BjornB2/retromodem/docs/RetroModem-Quick-Reference.pdf

RetroModem quick reference | github.com/BjornB2/retromodem

# RetroModem

ONE-PAGE QUICK REFERENCE - ACCESS, URLS, DIALLING AND CONTROLS

## Access and default credentials

Administration | http://retromodem.local/
Web login | retromodem / retromodem
Fallback access point retromodem
Access-point
password
| 12345678

Administration via AP http://10.42.0.1/

SSH | Imager account @ retromodem.local

## First use

### 1. Power on and wait about 20 seconds. 2. If normal Wi-Fi

is unavailable, join retromodem using 12345678; choose stay connected if warned that it has no internet. 3. Open retromodem.local or 10.42.0.1, sign in and select Wi-Fi.
4. Rejoin normal Wi-Fi and reopen retromodem.local. 5. Select the adapter and either Direct PPP or Hayes dial-up/BBS.

## Pages for the retro device

Start | http://start.retromodem/
Client settings | http://setup.retromodem/
Wi-Fi setup | http://wifi.retromodem/

Proxy routing/images http://proxy.retromodem/

Search | http://search.retromodem/
ChatGPT | http://chatgpt.retromodem/

## Network and proxy

The retro device must use RetroModem DNS 192.168.77.1. Direct PPP and dial-up PPP assign addresses automatically. Palm fallback: device IP 192.168.77.2, primary and secondary DNS 192.168.77.1. Fresh installations automatically send HTTP traffic through RetroWEB; change this at proxy.retromodem. Manual proxy: 192.168.77.1:8080.

## Virtual modem and dialling

Internet PPP | ATDT5559000 | user / blank
Bundled BBS entries | ATDT5551000 ... 5551009
ChatGPT BBS | ATDT5559999
Virtual Hayes speed | 115200 bit/s
Test command | AT -> OK

Phone-book numbers map modern Telnet BBS hostnames and ports to virtual telephone numbers; no physical telephone call is made.

## Button and LEDs

Short button press: switch Direct PPP / Hayes dial-up-BBS.
Hold 3 seconds: safe shutdown. Release when both LEDs flash; disconnect power only after the LEDs turn off. Status LEDs: show the active modem mode plus startup/network state.

## Connection hardware

MY018 GPIO/UART: preferred infrared build, tested up to 57.6 kbit/s. Prolific USB-RS-232: main wired route; use the correct device/null-modem cable. MA-620 USB IR: fallback infrared adapter at 9600 bit/s.

## SSH

ssh YOUR_USERNAME@retromodem.local
Use the account/password or key created in Raspberry Pi Imager. Through the fallback access point, replace the hostname with 10.42.0.1.

## Safety and help

Do not use the rewriting proxy for passwords, payments or sensitive accounts. Use http:// addresses in old browsers. Complete installation, wiring and device guides: github.com/BjornB2/retromodem.
