BjornB2/retromodem/docs/my018-aansluitschema.png

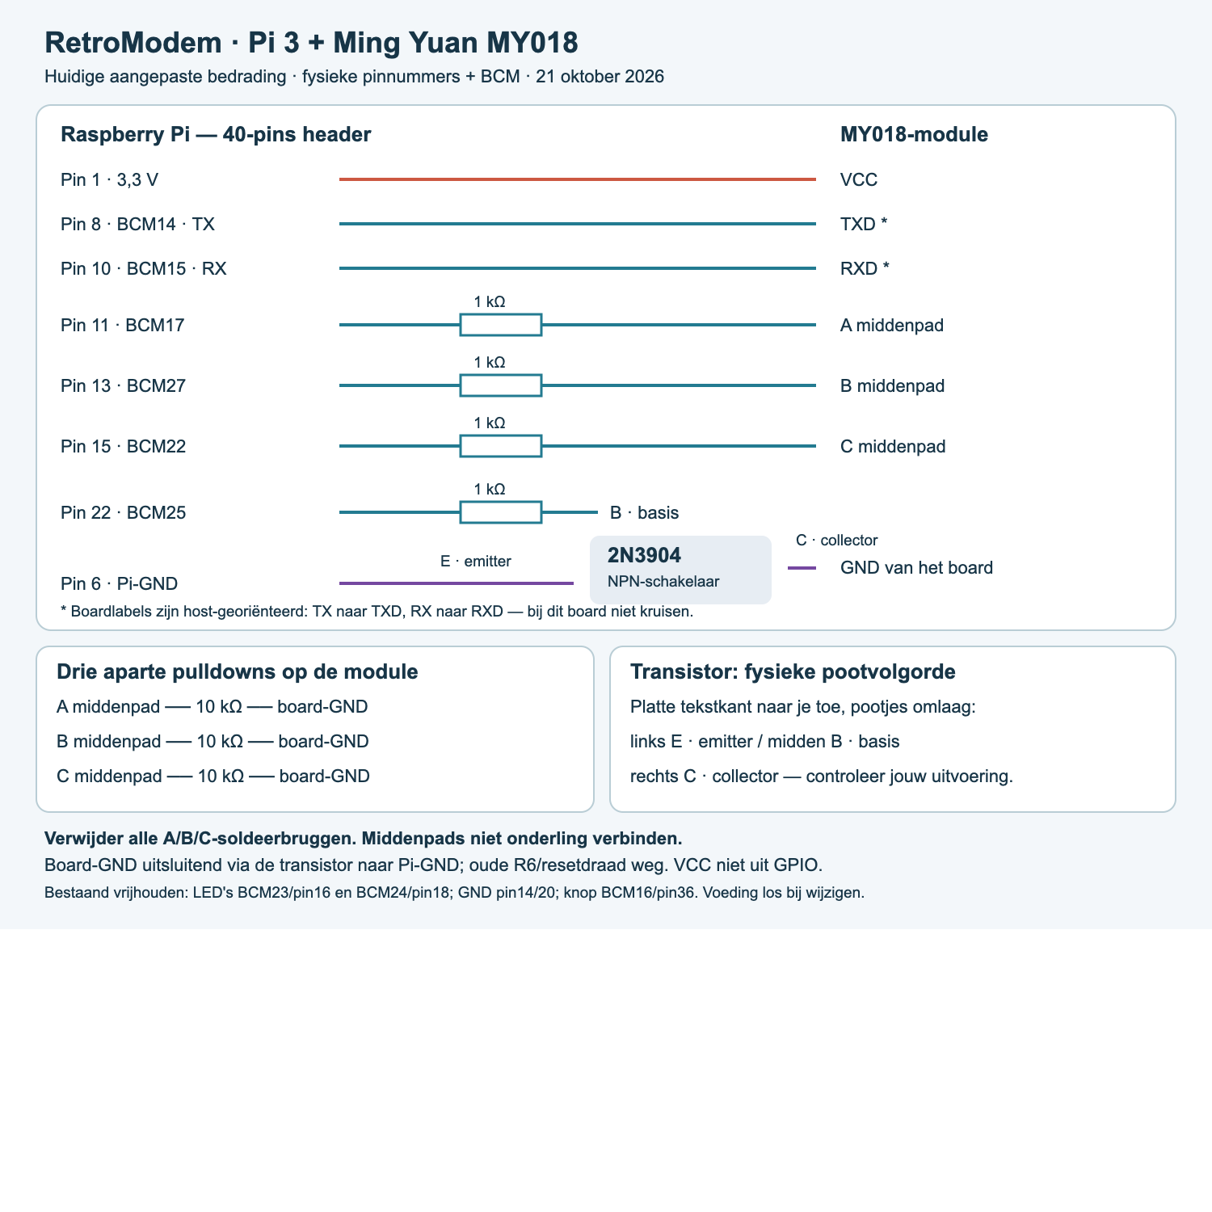
docs/my018-aansluitschema.png
