BjornB2/retromodem/docs/retromodem-hero.jpg

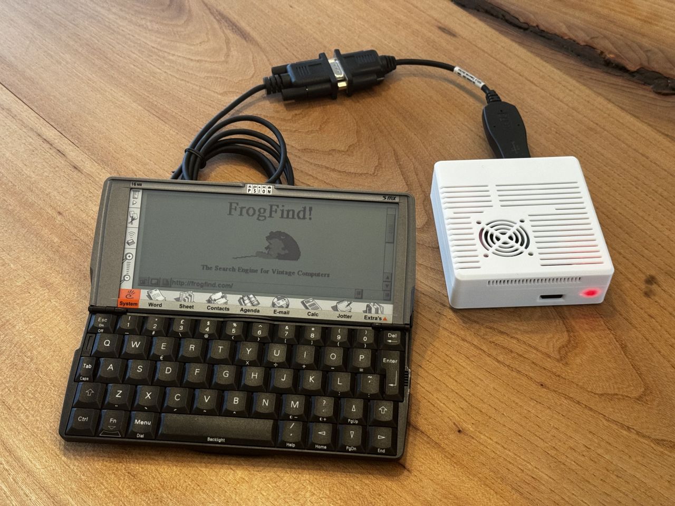
docs/retromodem-hero.jpg
