BjornB2/retromodem/docs/retroweb-interface.webp

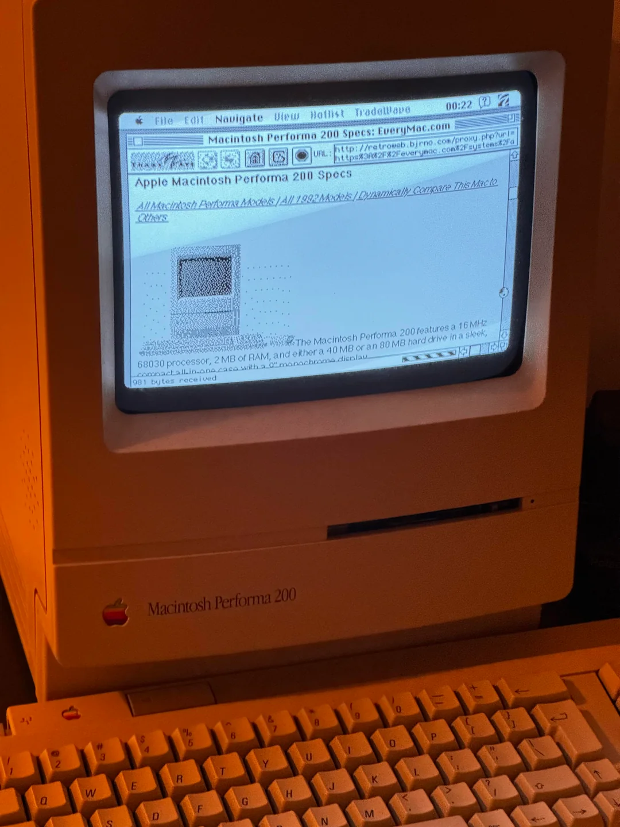
docs/retroweb-interface.webp
