BjornB2/retromodem/hardware/enclosure/RetroModem.step

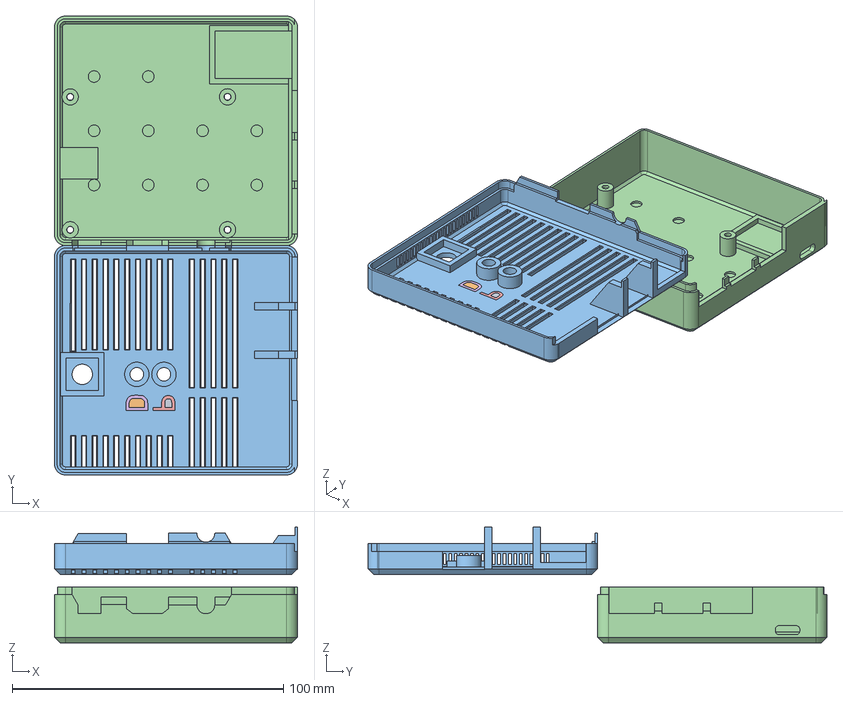
[picture p12: CAD file, 2026-10-28]
hardware/enclosure/RetroModem.step
89.6 x 169.2 x 42.6 mm
Case_Lid
Case_Main
