BjornB2/retromodem/hardware/enclosure/Retromodem_Bottom.stl

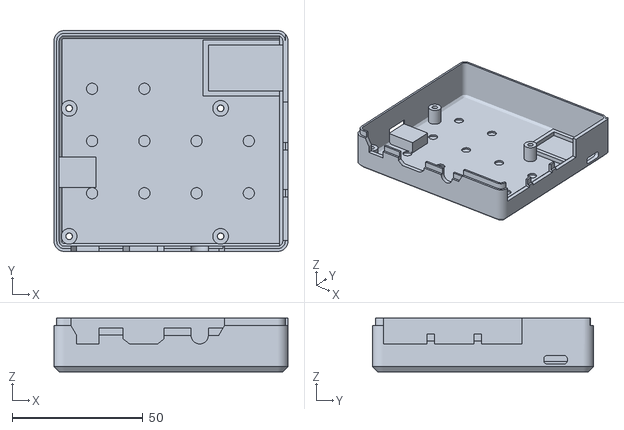
[picture p13: CAD file, 2026-10-28]
hardware/enclosure/Retromodem_Bottom.stl
89.6 x 84.6 x 20.6
