BjornB2/retromodem/hardware/enclosure/RetroModem_Lid.stl

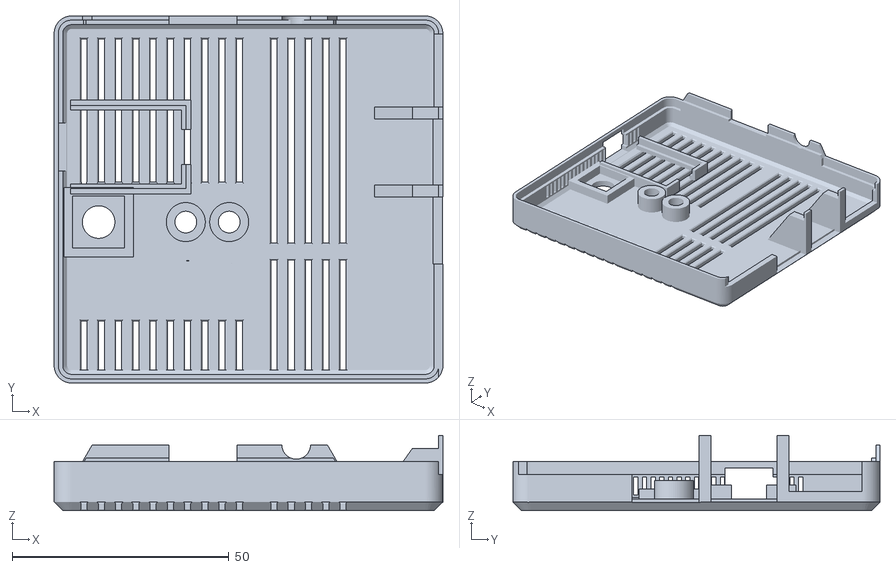
[picture p14: CAD file, 2026-10-28]
hardware/enclosure/RetroModem_Lid.stl
89.6 x 84.6 x 17.4
