BjornB2/retromodem/web/web.py

#!/usr/bin/python3
"""Small dependency-free configuration UI for the RetroModem appliance."""

from __future__ import annotations

import base64
import fcntl
import hashlib
import hmac
import html
import json
from email import policy
from email.parser import BytesParser
import os
import re
import secrets
import shlex
import signal
import subprocess
import tempfile
import threading
import time
import urllib.parse
from http import HTTPStatus
from http.cookies import SimpleCookie
from http.server import BaseHTTPRequestHandler, ThreadingHTTPServer
from pathlib import Path

try:
    import openai_auth
except ModuleNotFoundError:
    from web import openai_auth

CONFIG = Path("/etc/retromodem/retromodem.env")
PHONEBOOK = Path("/etc/retromodem/phonebook.json")
TRANSFERS = Path("/var/lib/retromodem/transfers")
RECEIVED = TRANSFERS / "received"
STATIC_ROOT = Path("/usr/local/share/retromodem/static")
LIBRARY_ROOT = Path("/var/lib/retromodem/software-library")
LIBRARY_META = LIBRARY_ROOT / "library.json"
SOFTWARE = {
    "psion-connectivity-3.10": {
        "name": "Mobile Connectivity Update 3.10",
        "file": "software/MobileConnectivityUpdate3.10.sis",
        "target": "psion", "protocol": "ymodem",
        "description_nl": "Update voor de mobiele verbindingssoftware van de Psion. Optioneel: installeer deze wanneer je EPOC-installatie de benodigde modem- of verbindingsopties mist.",
        "description_en": "Update for Psion mobile connectivity software. Optional: install when your EPOC installation lacks the required modem or connection options.",
        "compatibility": "Psion / EPOC · 3.10 · SIS",
    },
    "psion-web": {
        "name": "Web voor Psion",
        "file": "software/web.sis", "target": "psion", "protocol": "ymodem",
        "description_nl": "Webbrowser voor Psion/EPOC, geleverd als SIS-installatiepakket. Gebruik RetroWEB voor het bezoeken van moderne websites.",
        "description_en": "Web browser for Psion/EPOC, supplied as a SIS installation package. Use RetroWEB to browse modern websites.",
        "compatibility": "Psion / EPOC · SIS",
    },
    "psion-nirc": {
        "name": "nIRC",
        "file": "software/nirc.sis", "target": "psion", "protocol": "ymodem",
        "description_nl": "IRC-chatclient voor Psion/EPOC. Maak een internetverbinding en configureer in de app een IRC-server om aan kanalen en gesprekken deel te nemen.",
        "description_en": "IRC chat client for Psion/EPOC. Connect to the internet and configure an IRC server in the app to join channels and conversations.",
        "compatibility": "Psion / EPOC · SIS",
    },
    "palmterm-retromodem-0.1.34": {
        "name": "PalmTerm for RetroModem 0.1.34",
        "file": "software/PalmTerm-RetroIRModem-0.1.34.prc",
        "description_nl": "ANSI/VT100-terminal met kleur, CP437, scrollback en 80×25-overzicht. Inclusief RetroModem BBS- en ChatGPT-telefoonboek.",
        "description_en": "ANSI/VT100 terminal with colour, CP437, scrollback and an 80×25 overview. Includes the RetroModem BBS and ChatGPT phone book.",
        "compatibility": "Palm OS 4.0/4.1 · Palm IIIc · MIT",
        "source": "https://github.com/BjornB2/PalmTerm",
        "protocol": "palm",
    },
    "rbrowser-0.1.35": {
        "name": "RetroModem Browser 0.1.35",
        "file": "software/RBrowser-0.1.35.prc",
        "description_nl": "Browser voor RetroWEB met eenvoudige HTML-weergave en inline GIF-afbeeldingen. Startpagina: retroweb.bjrno.com.",
        "description_en": "Browser for RetroWEB with basic HTML rendering and inline GIF images. Home page: retroweb.bjrno.com.",
        "compatibility": "Palm OS 4.0/4.1 · Palm IIIc · MIT",
        "source": "https://github.com/BjornB2/palm-retroweb-browser",
        "protocol": "palm",
    },
    "eudoraweb-2.1": {
        "name": "EudoraWeb 2.1",
        "file": "software/EudoraWeb_2.1.prc",
        "description_nl": "Snelle tekstbrowser zonder afbeeldingen. Getest met installatie via Palm Beam op Palm OS 4.1.",
        "description_en": "Fast text browser without images. Installation over Palm Beam tested on Palm OS 4.1.",
        "compatibility": "Palm OS 3.0–5.4 · freeware",
        "source": "https://palmdb.net/app/eudora-eis",
        "protocol": "palm",
    },
    "mocha-telnet-3.0": {
        "name": "Mocha Telnet 3.0",
        "file": "software/MochaTelnet_3.0.prc",
        "description_nl": "Telnet/VT100/VT220- en SSH2-client voor klassieke Palms. Freewaresleutel: 119377.",
        "description_en": "Telnet/VT100/VT220 and SSH2 client for classic Palms. Freeware key: 119377.",
        "compatibility": "Palm OS 3.0+ · freeware",
        "source": "https://www.mochasoft.dk/palm2.htm",
        "protocol": "palm",
    },
}
ALLOWED_BITRATES = {"9600", "19200", "38400", "57600", "115200"}
CSRF_TOKENS: set[str] = set()
GUIDE_TARGETS = {"generic", "psion", "palm-old", "palm-new", "hp200lx", "win95", "win98", "winxp"}
LIBRARY_PROTOCOLS = {"download", "palm", "epoc", "xmodem", "ymodem", "zmodem"}
IR_ADAPTERS = {
    "ming-yuan-my018": {"name": "Ming Yuan MY018 · GPIO", "prefix": "MY018", "tty": "/dev/serial0", "dongle": ""},
    "mobile-action-ma620": {"name": "Mobile Action MA-620 · USB fallback", "prefix": "MA620", "tty": "auto", "dongle": "ma600"},
}


def pending_send() -> dict[str, str] | None:
    """Resolve only a web-created work copy, never an arbitrary posted path."""
    try:
        item = json.loads((TRANSFERS / "pending-send.json").read_text())
        token, name = item["token"], item["filename"]
        if not re.fullmatch(r"work-[a-f0-9]{12}", token) or Path(name).name != name:
            return None
        candidate = TRANSFERS / token / name
        if candidate.parent.resolve().parent != TRANSFERS.resolve() or candidate.is_symlink() or not candidate.is_file():
            return None
        return {"token": token, "filename": name, "protocol": item["protocol"]}
    except (OSError, ValueError, KeyError, TypeError):
        return None


def remember_send(path: Path, protocol: str) -> None:
    save = {"token": path.parent.name, "filename": path.name, "protocol": protocol}
    target = TRANSFERS / "pending-send.json"
    temporary = target.with_suffix(".tmp")
    temporary.write_text(json.dumps(save), encoding="utf-8")
    os.replace(temporary, target)


def ir_adapter_id(config: dict[str, str]) -> str:
    value = config.get("RETROMODEM_ADAPTER", "ming-yuan-my018")
    return value if value in IR_ADAPTERS else "ming-yuan-my018"


def my018_power_enabled(config: dict[str, str]) -> bool:
    return config.get("RETROMODEM_MY018_POWER_CYCLE", "0") == "1"


def ir_adapter_settings(config: dict[str, str], language: str) -> str:
    active = ir_adapter_id(config)
    options = ''.join(f'<option value="{key}" {"selected" if key == active else ""}>{item["name"]}</option>' for key, item in IR_ADAPTERS.items())
    result = f'<label>{tr(language,"Infraroodadapter","Infrared adapter")}</label><select name="irda_adapter" id="irda-adapter">{options}</select>'
    for key, item in IR_ADAPTERS.items():
        prefix = item["prefix"]
        current = key == active
        physical = config.get(f"RETROMODEM_{prefix}_BITRATE", config.get("RETROMODEM_IRDA_BITRATE", "9600") if current else "9600")
        virtual = config.get(f"RETROMODEM_{prefix}_DIALUP_BITRATE", config.get("RETROMODEM_IRDA_DIALUP_BITRATE", "115200") if current else "115200")
        my018 = key == "ming-yuan-my018"
        controlled = my018_power_enabled(config)
        if my018:
            message = (tr(language, "Automatische snelheidskeuze via A/B/C en de transistorschakeling. Getest op 57k6: PPP met Palm IIIc en Psion 5mx, en Palm Beam naar de Palm. 38k4 is nog niet getest; 19k2 is alleen gedeeltelijk getest.", "Automatic speed selection through A/B/C and the transistor power switch. Tested at 57.6k: PPP with Palm IIIc and Psion 5mx, and Beam to Palm. 38.4k is untested; 19.2k was only partially tested.") if controlled else tr(language, "Vaste 9600-configuratie: bruggen A0/B0/C0. Hogere snelheden vereisen aangepaste bedrading, een voedingsschakelaar en de bijbehorende driver; sluit GPIO-draden niet aan op gesloten bruggen.", "Fixed 9600 configuration: A0/B0/C0 bridges. Higher rates require modified wiring, a power switch and the matching driver; never connect GPIO outputs to closed bridges."))
        else:
            message = tr(language,"Met deze MA-620 is alleen 9600 bit/s betrouwbaar gebleken. Hogere waarden zijn experimenteel.","Only 9600 bps has proven reliable with this MA-620. Higher settings are experimental.")
        rates = ("9600",) if my018 and not controlled else ("9600", "19200", "38400", "57600", "115200")
        labels = {"9600": "9600", "19200": tr(language, "19200 — gedeeltelijk getest", "19200 — partially tested"), "38400": tr(language, "38400 — nog niet getest", "38400 — untested"), "57600": tr(language, "57600 — getest, aanbevolen", "57600 — tested, recommended"), "115200": tr(language, "115200 — experimenteel, waarschuwing", "115200 — experimental, warning")}
        choices = ''.join(f'<option value="{rate}" {"selected" if rate == physical else ""}>{labels[rate] if my018 else rate}</option>' for rate in rates)
        virtual_choices = ''.join(f'<option value="{rate}" {"selected" if rate == virtual else ""}>{rate}</option>' for rate in ("9600", "19200", "38400", "57600", "115200"))
        warning = (f'<p class="notice warning" data-speed-warning="115200" role="status" {"" if physical == "115200" else "hidden"}>{tr(language,"115k2 is niet stabiel aangetoond: onze Palm Beam-tests leverden geen werkende verbinding op. Ook Psion PPP op 115k2 is niet bevestigd. Dit is geen algemene IrDA-limiet. Kies bij problemen 57k6 of 9600 en verbind opnieuw.","115.2k is not proven stable: our Palm Beam tests failed to connect. Psion PPP at 115.2k is also unconfirmed. This is not a general IrDA limit. If it fails, select 57.6k or 9600 and reconnect.")}</p>' if my018 else '')
        result += f'<div data-ir-profile="{key}"><h3>{item["name"]}</h3><p class="notice {"" if my018 else "warning"}">{message}</p><label>{tr(language,"Maximale fysieke IrDA-linksnelheid","Maximum physical IrDA link speed")}</label><select name="{prefix.lower()}_bitrate">{choices}</select>{warning}<p class="helper">{tr(language,"Ontdekking begint op 9600 bit/s. Daarna onderhandelen de apparaten een snelheid tot dit maximum. Een gewijzigde limiet geldt voor een nieuwe verbinding; toepassen verbreekt de huidige sessie.","Discovery starts at 9600 bps, then devices negotiate up to this maximum. A changed limit applies to a new connection; applying disconnects the current session.")}</p><label>{tr(language,"Virtuele poortsnelheid voor inbelmodem/Comms","Virtual port speed for dial-up modem/Comms")}</label><select name="{prefix.lower()}_dialup_bitrate">{virtual_choices}</select><p class="helper">{tr(language,"De virtuele poortsnelheid verandert de fysieke infraroodsnelheid niet. Instellingen worden per adapter bewaard.","The virtual port speed does not change the physical infrared speed. Settings are saved separately for each adapter.")}</p></div>'
    return result


def load_config() -> dict[str, str]:
    values = {k: v for k, v in os.environ.items() if k.startswith("RETROMODEM_")}
    try:
        lines = CONFIG.read_text(encoding="utf-8").splitlines()
    except FileNotFoundError:
        lines = []
    for line in lines:
        if not line or line.lstrip().startswith("#") or "=" not in line:
            continue
        key, value = line.split("=", 1)
        if re.fullmatch(r"RETROMODEM_[A-Z0-9_]+", key):
            try:
                parsed = shlex.split(value, posix=True)
                values[key] = parsed[0] if parsed else ""
            except ValueError:
                continue
    return values


CONFIG_WRITE_LOCK = threading.RLock()


def save_config(changes: dict[str, str]) -> None:
    CONFIG.parent.mkdir(parents=True, exist_ok=True)
    with CONFIG_WRITE_LOCK:
        fd = os.open(str(CONFIG) + '.lock', os.O_CREAT | os.O_RDWR | os.O_NOFOLLOW, 0o600)
        with os.fdopen(fd, 'a') as lock:
            fcntl.flock(lock, fcntl.LOCK_EX)
            _save_config_unlocked(changes)


def _save_config_unlocked(changes: dict[str, str]) -> None:
    current = load_config()
    current.update(changes)
    lines = [f"{key}={shlex.quote(current[key])}" for key in sorted(current)]
    CONFIG.parent.mkdir(parents=True, exist_ok=True)
    fd, name = tempfile.mkstemp(prefix="retromodem.env.", dir=CONFIG.parent, text=True)
    try:
        with os.fdopen(fd, "w", encoding="utf-8") as stream:
            stream.write("\n".join(lines) + "\n")
        os.chmod(name, 0o600)
        os.replace(name, CONFIG)
    finally:
        try:
            os.unlink(name)
        except FileNotFoundError:
            pass


def load_phonebook() -> list[dict[str, object]]:
    try:
        document = json.loads(PHONEBOOK.read_text(encoding="utf-8"))
        entries = document.get("entries", [])
    except (FileNotFoundError, json.JSONDecodeError, AttributeError):
        return []
    return entries if isinstance(entries, list) else []


def save_phonebook(entries: list[dict[str, object]]) -> None:
    PHONEBOOK.parent.mkdir(parents=True, exist_ok=True)
    fd, name = tempfile.mkstemp(prefix="phonebook.json.", dir=PHONEBOOK.parent, text=True)
    try:
        with os.fdopen(fd, "w", encoding="utf-8") as stream:
            json.dump({"schema_version": 1, "entries": entries}, stream, indent=2, ensure_ascii=False)
            stream.write("\n")
        os.chmod(name, 0o600)
        os.replace(name, PHONEBOOK)
    finally:
        try:
            os.unlink(name)
        except FileNotFoundError:
            pass


def load_library() -> dict[str, dict[str, str]]:
    try:
        document = json.loads(LIBRARY_META.read_text(encoding="utf-8"))
        items = document.get("items", {})
    except (FileNotFoundError, json.JSONDecodeError, AttributeError):
        return {}
    if not isinstance(items, dict):
        return {}
    return {str(key): value for key, value in items.items() if isinstance(value, dict)}


def save_library(items: dict[str, dict[str, str]]) -> None:
    LIBRARY_ROOT.mkdir(parents=True, exist_ok=True)
    fd, name = tempfile.mkstemp(prefix="library.", suffix=".json", dir=LIBRARY_ROOT, text=True)
    try:
        with os.fdopen(fd, "w", encoding="utf-8") as stream:
            json.dump({"schema_version": 1, "items": items}, stream, indent=2, ensure_ascii=False)
            stream.write("\n")
        os.chmod(name, 0o600)
        os.replace(name, LIBRARY_META)
    finally:
        try:
            os.unlink(name)
        except FileNotFoundError:
            pass


def software_catalog() -> dict[str, dict[str, object]]:
    catalog = {key: dict(value, uploaded=False) for key, value in SOFTWARE.items()}
    catalog.update({key: dict(value, uploaded=True) for key, value in load_library().items()})
    for item in catalog.values():
        if item.get('protocol') == 'download':
            item['protocol'] = 'ymodem'
    return catalog


def library_filename(item: dict[str, object], source: Path) -> str:
    """Keep storage IDs private; retain the original name on the wire."""
    name = Path(str(item.get('original_name') or source.name)).name
    name = re.sub(r'[^A-Za-z0-9._ -]', '_', name)[:120]
    return name if name not in {'', '.', '..'} else 'bestand.bin'


def save_transfer_status(document: dict[str, object]) -> None:
    TRANSFERS.mkdir(parents=True, exist_ok=True)
    fd, name = tempfile.mkstemp(prefix="status.", suffix=".json", dir=TRANSFERS, text=True)
    try:
        with os.fdopen(fd, "w", encoding="utf-8") as stream:
            json.dump(document, stream, ensure_ascii=False)
        os.chmod(name, 0o644)
        os.replace(name, TRANSFERS / "status.json")
    finally:
        try:
            os.unlink(name)
        except FileNotFoundError:
            pass


def transfer_process_alive(status: dict[str, object]) -> bool:
    try:
        pid = int(status.get("pid", 0))
        command = Path(f"/proc/{pid}/cmdline").read_bytes().replace(b"\0", b" ")
    except (FileNotFoundError, ValueError, PermissionError):
        return False
    return b"retromodem/transfer.py" in command


def phonebook_entry(form: dict[str, str]) -> dict[str, object]:
    number = form.get("number", "").strip()
    label = form.get("label", "").strip()
    kind = form.get("kind", "bbs")
    host = form.get("host", "").strip()
    try:
        port = int(form.get("port", "0"))
    except ValueError as error:
        raise ValueError("Ongeldige poort") from error
    if not re.fullmatch(r"[0-9*#]{1,32}", number):
        raise ValueError("Een telefoonnummer mag alleen cijfers, * en # bevatten")
    if not label or len(label) > 80:
        raise ValueError("Ongeldige naam")
    if kind not in {"ppp", "bbs"}:
        raise ValueError("Ongeldig type")
    if not re.fullmatch(r"[A-Za-z0-9.-]{1,253}", host) or ".." in host:
        raise ValueError("Ongeldige hostnaam")
    if not 1 <= port <= 65535:
        raise ValueError("Ongeldige poort")
    return {"number": number, "label": label, "kind": kind, "host": host, "port": port}


def run(*args: str, timeout: int = 8, env: dict[str, str] | None = None) -> subprocess.CompletedProcess[str]:
    try:
        return subprocess.run(args, text=True, capture_output=True, timeout=timeout, check=False, env=env)
    except (FileNotFoundError, subprocess.TimeoutExpired) as error:
        return subprocess.CompletedProcess(args, 127, "", str(error))


def service_active(name: str) -> bool:
    return run("/usr/bin/systemctl", "is-active", "--quiet", name).returncode == 0


def process_running(name: str) -> bool:
    return run("/usr/bin/pgrep", "-x", name).returncode == 0


def wifi_state(config: dict[str, str]) -> tuple[str, str]:
    interface = config.get("RETROMODEM_WIFI_INTERFACE", "wlan0")
    result = run("/usr/bin/nmcli", "-g", "GENERAL.STATE,GENERAL.CONNECTION", "device", "show", interface)
    fields = result.stdout.strip().splitlines()
    state = fields[0] if fields else "onbekend"
    profile = fields[1] if len(fields) > 1 else ""
    ssid = ""
    if profile and profile not in {"--", "—"}:
        ssid_result = run("/usr/bin/nmcli", "-g", "802-11-wireless.ssid", "connection", "show", profile)
        if ssid_result.returncode == 0:
            ssid = ssid_result.stdout.strip().splitlines()[0] if ssid_result.stdout.strip() else ""
    return state, ssid


def scan_wifi(config: dict[str, str]) -> list[tuple[str, int, str]]:
    interface = config.get("RETROMODEM_WIFI_INTERFACE", "wlan0")
    result = run(
        "/usr/bin/nmcli", "-t", "--escape", "yes",
        "-f", "SSID,SIGNAL,SECURITY", "device", "wifi", "list",
        "ifname", interface, "--rescan", "yes", timeout=20,
    )
    networks: dict[str, tuple[int, str]] = {}
    for line in result.stdout.splitlines():
        # nmcli escapes literal colons as \:; split only unescaped separators.
        parts = re.split(r"(?<!\\):", line, maxsplit=2)
        if len(parts) != 3:
            continue
        ssid = parts[0].replace(r"\:", ":").replace(r"\\", "\\")
        if not ssid or ssid == config.get("RETROMODEM_AP_SSID", "retromodem"):
            continue
        try:
            signal = int(parts[1])
        except ValueError:
            signal = 0
        if ssid not in networks or signal > networks[ssid][0]:
            networks[ssid] = (signal, parts[2] or "open")
    return sorted(((ssid, *data) for ssid, data in networks.items()), key=lambda item: -item[1])


def usb_inventory() -> list[dict[str, str]]:
    """Return known and unknown USB adapters, including their tty node."""
    known = {
        "0df7:0620": ("Mobile Action MA-620", "irda"),
        "067b:2303": ("Prolific PL2303", "serial"),
    }
    ttys: dict[str, str] = {}
    for candidate in sorted(Path("/dev").glob("ttyUSB*")):
        info = run("/usr/bin/udevadm", "info", "--query=property", f"--name={candidate}").stdout
        properties = dict(line.split("=", 1) for line in info.splitlines() if "=" in line)
        usb_id = f"{properties.get('ID_VENDOR_ID', '')}:{properties.get('ID_MODEL_ID', '')}".lower()
        if usb_id != ":":
            ttys[usb_id] = str(candidate)
    found: list[dict[str, str]] = []
    for line in run("/usr/bin/lsusb").stdout.splitlines():
        match = re.search(r"ID ([0-9a-fA-F]{4}:[0-9a-fA-F]{4}) (.+)$", line)
        if not match:
            continue
        usb_id, description = match.group(1).lower(), match.group(2).strip()
        if usb_id not in known and usb_id not in ttys:
            continue
        name, transport = known.get(usb_id, (description, "other"))
        found.append({"usb_id": usb_id, "name": name, "description": description,
                      "transport": transport, "tty": ttys.get(usb_id, "—")})
    return found


def ipv4_addresses() -> list[str]:
    result = run("/usr/bin/hostname", "-I")
    return [address for address in result.stdout.split() if ":" not in address]


def transfer_status() -> dict[str, object]:
    try:
        status = json.loads((TRANSFERS / "status.json").read_text(encoding="utf-8"))
        return status if isinstance(status, dict) else {}
    except (FileNotFoundError, json.JSONDecodeError):
        return {}


def tr(language: str, nl: str, en: str) -> str:
    return en if language == "en" else nl


def human_size(size: int) -> str:
    if size >= 1024 * 1024:
        return f"{size / (1024 * 1024):.1f} MB"
    if size >= 1024:
        return f"{size / 1024:.1f} kB"
    return f"{size} bytes"


def transfer_estimate(size: int, protocol: str, config: dict[str, str]) -> str:
    """Return a deliberately conservative estimate for the active transport."""
    ir_only = protocol in {"palm", "epoc", "windows"}
    transport = "irda" if ir_only else config.get("RETROMODEM_TRANSPORT", "irda")
    if transport == "irda":
        configured = int(config.get("RETROMODEM_IRDA_BITRATE", "9600"))
        # This MA-620 specimen is only physically verified at 9600 bit/s;
        # the virtual 115200-baud IrCOMM setting does not raise air throughput.
        bitrate = min(configured, 9600) if ir_adapter_id(config) == "mobile-action-ma620" else configured
        medium = "IR"
    else:
        bitrate = int(config.get("RETROMODEM_SERIAL_BITRATE", "115200"))
        medium = tr(config.get("RETROMODEM_LANGUAGE", "en"), "USB-serieel", "USB serial")
    efficiency = {"xmodem": 0.70, "ymodem": 0.78, "zmodem": 0.82,
                  "palm": 0.72, "epoc": 0.72, "windows": 0.72}.get(protocol, 0.75)
    seconds = max(1, int((size * 10 / max(1, bitrate) / efficiency) + (3 if transport == "irda" else 1) + 0.999))
    if seconds < 60:
        duration = f"±{seconds} sec"
    else:
        minutes, remainder = divmod(seconds, 60)
        duration = f"±{minutes}:{remainder:02d} min"
    return f"{duration} via {medium} ({bitrate} bit/s)"


def software_card(language: str, *, title: str, description: str, compatibility: str,
                  software_id: str = "", source: str = "") -> str:
    """Render one guide download with only actions the appliance can honour."""
    actions = []
    metadata = [compatibility]
    if software_id:
        item = software_catalog()[software_id]
        uploaded = bool(item.get("uploaded"))
        asset = ((LIBRARY_ROOT / Path(str(item.get("stored_name", ""))).name)
                 if uploaded else STATIC_ROOT / str(item["file"]))
        if asset.is_file():
            size = asset.stat().st_size
            metadata.append(human_size(size))
            if item.get("protocol") != "download":
                metadata.append(transfer_estimate(
                    size, str(item.get("protocol", "download")), load_config()
                ))
        href = (f'/library/download?id={urllib.parse.quote(software_id)}' if uploaded
                else f'/static/{item["file"]}')
        actions.append(
            f'<a class="button secondary" download href="{href}">'
            f'{tr(language,"Downloaden","Download")}</a>'
        )
        if item.get("protocol") != "download":
            send_label = (tr(language, "Via YMODEM versturen", "Send via YMODEM") if item.get("protocol") == "ymodem" else tr(language, "Via IR versturen", "Send over IR")
                          if item.get("protocol") in {"palm", "epoc"}
                          else tr(language, "Naar apparaat sturen", "Send to device"))
            actions.append(
                f'<form method="post" action="/transfer/library-send">'
                f'<input type="hidden" name="csrf" value="{{{{csrf}}}}">'
                f'<input type="hidden" name="software" value="{html.escape(software_id, quote=True)}">'
                f'<button class="primary" type="submit">{send_label}</button>'
                f'</form>'
            )
        if uploaded:
            actions.append(
                f'<form method="post" action="/guides/library-delete" '
                f'onsubmit="return confirm(\'{tr(language,"Dit bestand verwijderen?","Delete this file?")}\')">'
                f'<input type="hidden" name="csrf" value="{{{{csrf}}}}">'
                f'<input type="hidden" name="software" value="{html.escape(software_id, quote=True)}">'
                f'<button class="ghost" type="submit">{tr(language,"Verwijderen","Delete")}</button>'
                f'</form>'
            )
    if source:
        actions.append(
            f'<a class="button ghost" rel="noopener" href="{html.escape(source, quote=True)}">'
            f'{tr(language,"Bron / project","Source / project")}</a>'
        )
    return (
        f'<article class="software-card"><div><h3>{html.escape(title)}</h3>'
        f'<p>{description}</p><small class="helper">{" · ".join(metadata)}</small></div>'
        f'<div class="software-actions">{"".join(actions)}</div></article>'
    )


def uploaded_guide_sections(language: str) -> str:
    """Return escaped, per-guide HTML fragments for user-uploaded files."""
    grouped: dict[str, list[str]] = {target: [] for target in GUIDE_TARGETS}
    for software_id, item in load_library().items():
        target = str(item.get("target", "generic"))
        if target not in grouped:
            continue
        grouped[target].append(software_card(
            language,
            title=str(item.get("title", item.get("original_name", "Bestand"))),
            description=html.escape(str(item.get("description", ""))),
            compatibility=html.escape(str(item.get("compatibility", ""))),
            software_id=software_id,
        ))
    sections = {
        target: (f'<h3>{tr(language,"Zelf toegevoegde bestanden","Uploaded files")}</h3>'
                 f'<div class="software-list">{"".join(cards)}</div>')
        for target, cards in grouped.items() if cards
    }
    return json.dumps(sections, ensure_ascii=False).replace("<", "\\u003c")


def library_upload_form(language: str) -> str:
    return files_upload_form(language)


FILE_SYSTEMS = {'palm': 'Palm OS', 'psion': 'Psion / EPOC', 'dos': 'DOS', 'windows': 'Windows', 'generic': 'Algemeen / General'}


def file_os(target):
    return {'palm-old': 'palm', 'palm-new': 'palm', 'hp200lx': 'dos',
            'win95': 'windows', 'win98': 'windows', 'winxp': 'windows'}.get(target, target if target in FILE_SYSTEMS else 'generic')


def files_upload_form(language):
    options = ''.join(f'<option value="{key}">{label}</option>' for key, label in FILE_SYSTEMS.items())
    return f'''<details class="card"><summary>{tr(language,'Bestand toevoegen','Add file')}</summary><form method="post" action="/guides/upload" enctype="multipart/form-data"><input type="hidden" name="csrf" value="{{{{csrf}}}}"><label>{tr(language,'Bestand','File')}</label><input type="file" name="file" required><label>OS</label><select name="target">{options}</select><label>{tr(language,'Bron-URL (optioneel)','Source URL (optional)')}</label><input type="url" name="source" maxlength="2048" placeholder="https://github.com/…"><label>{tr(language,'Titel','Title')}</label><input name="title" maxlength="80" required><label>{tr(language,'Beschrijving','Description')}</label><input name="description" maxlength="240" required><label>{tr(language,'Versie / compatibiliteit','Version / compatibility')}</label><input name="compatibility" maxlength="120"><label>{tr(language,'Overdrachtsmethode','Transfer method')}</label><select name="protocol"><option value="palm">Palm Beam (PRC/PDB)</option><option value="ymodem">YMODEM</option><option value="xmodem">XMODEM</option><option value="zmodem">ZMODEM</option><option value="epoc">EPOC EikonIr</option></select><button type="submit">{tr(language,'Toevoegen','Add')}</button></form></details>'''


def files_library(language):
    groups = {key: [] for key in FILE_SYSTEMS}
    for software_id, original in software_catalog().items():
        item = dict(original)
        uploaded = bool(item.get('uploaded'))
        asset = LIBRARY_ROOT / Path(str(item.get('stored_name', ''))).name if uploaded else STATIC_ROOT / str(item['file'])
        if not asset.is_file():
            continue
        target = file_os(str(item.get('target', 'palm' if not uploaded else 'generic')))
        groups[target].append(software_card(language, title=str(item.get('title', item.get('name', asset.name))),
            description=html.escape(str(item.get('description_' + language, item.get('description', '')))), compatibility=html.escape(str(item.get('compatibility', ''))), software_id=software_id, source=str(item.get('source', ''))))
    labels = dict(FILE_SYSTEMS, generic=tr(language,'Algemeen','General'))
    psion_notice = '<div class="notice">' + tr(language,'<strong>Versturen via YMODEM in Comms.</strong> Directe IR-bestandsoverdracht (EikonIr) werkt minder betrouwbaar. Open op de Psion Comms, kies Ontvangen en YMODEM en start daarna hier het verzenden. Open na ontvangst het SIS-bestand op de Psion om het te installeren.','<strong>Send using YMODEM in Comms.</strong> Direct IR file transfer (EikonIr) is less reliable. On the Psion open Comms, select Receive and YMODEM, then start sending here. After receipt, open the SIS file on the Psion to install it.') + '</div>'
    tabs = ''.join(f'<button type="button" role="tab" data-file-os="{key}">{label}</button>' for key,label in labels.items())
    panels = ''.join(f'<section class="card file-os" id="files-{key}"><h2>{label}</h2><div class="software-list">' + (''.join(groups[key]) or '<p>' + tr(language,'Nog geen bestanden. Voeg hierboven een bestand toe.','No files yet. Add a file above.') + '</p>') + '</div></section>' for key,label in FILE_SYSTEMS.items())
    panels = panels.replace('class="card file-os"', 'class="card file-os content-stack"')
    panels = panels.replace('<h2>Psion / EPOC</h2>', '<h2>Psion / EPOC</h2>' + psion_notice)
    return '<div class="library-heading"><h2>'+tr(language,'Bestandsbibliotheek','File library')+'</h2><p>'+tr(language,'Kies een besturingssysteem om bestanden te bekijken of toe te voegen.','Choose an operating system to browse or add files.')+'</p></div><div class="file-os-tabs" role="tablist" aria-label="OS">'+tabs+'</div>'+files_upload_form(language)+panels+'''<style>.files-library{margin-top:48px;padding-top:32px;border-top:1px solid var(--line);display:flex;flex-direction:column;gap:24px}.library-heading h2{font-size:1.6rem;margin-bottom:8px}.library-heading p{margin:0;color:var(--muted)}.file-os-tabs{display:flex;flex-wrap:wrap;gap:8px;border-bottom:1px solid var(--line);padding-bottom:16px}.file-os-tabs button{margin:0;background:transparent;color:var(--graphite);border:1px solid var(--line);box-shadow:none}.file-os-tabs button.active{background:var(--graphite);color:white;border-color:var(--graphite)}.files-library .file-os[hidden]{display:none}.files-library details.card{margin:0}.files-library .file-os{margin:0}.files-library .software-list{display:grid;gap:16px}#transfer-status{margin-bottom:24px}</style><script>const fileTabs=document.querySelectorAll('[data-file-os]');function showFileOS(os){if(![...fileTabs].some(b=>b.dataset.fileOs===os))os='palm';document.querySelectorAll('.file-os').forEach(p=>p.hidden=p.id!=='files-'+os);fileTabs.forEach(b=>{b.classList.toggle('active',b.dataset.fileOs===os);b.setAttribute('aria-selected',String(b.dataset.fileOs===os))});document.querySelector('select[name=target]').value=os}fileTabs.forEach(b=>b.addEventListener('click',()=>{history.replaceState(null,'','#files-'+b.dataset.fileOs);showFileOS(b.dataset.fileOs)}));showFileOS(location.hash.startsWith('#files-')?location.hash.slice(7):'palm');</script>'''


def legacy_library_upload_form(language: str) -> str:
    return f"""<details class="card library-upload"><summary>{tr(language,'Softwarebibliotheek beheren','Manage software library')}</summary><p>{tr(language,'Voeg software of documentatie toe aan de handleiding van een apparaat.','Add software or documentation to a device guide.')}</p><form method="post" action="/guides/upload" enctype="multipart/form-data"><input type="hidden" name="csrf" value="{{{{csrf}}}}"><label>{tr(language,'Bestand','File')}</label><input type="file" name="file" required><div class="grid"><div class="span-6"><label>{tr(language,'Titel','Title')}</label><input name="title" maxlength="80" required></div><div class="span-6"><label>{tr(language,'Hoort bij','Belongs to')}</label><select name="target"><option value="generic">{tr(language,'Algemeen','Generic')}</option><option value="psion">Psion 5mx</option><option value="palm-old">Palm OS 3.0/3.1</option><option value="palm-new">Palm OS 3.3–5.x</option><option value="hp200lx">HP 200LX</option><option value="win95">Windows 95</option><option value="win98">Windows 98</option><option value="winxp">Windows XP</option></select></div></div><label>{tr(language,'Korte uitleg','Short description')}</label><input name="description" maxlength="240" required><label>{tr(language,'Compatibiliteit of versie','Compatibility or version')}</label><input name="compatibility" maxlength="120" placeholder="Palm OS 4.1 · freeware"><label>{tr(language,'Actie naast downloaden','Action besides downloading')}</label><select name="protocol"><option value="download">{tr(language,'Alleen downloaden','Download only')}</option><option value="palm">Palm Beam (IrOBEX)</option><option value="epoc">Psion/EPOC EikonIr</option><option value="ymodem">YMODEM</option><option value="xmodem">XMODEM</option><option value="zmodem">ZMODEM</option></select><button class="primary" type="submit">{tr(language,'Toevoegen aan bibliotheek','Add to library')}</button></form></details>"""


def proxy_settings_card(language: str, config: dict[str, str]) -> str:
    mode = config.get("RETROMODEM_PROXY_MODE", "manual")
    if mode in {"transparent", "transparent-online"}:
        mode = "automatic"
    if mode not in {"manual", "automatic"}:
        mode = "manual"
    values = config.get("RETROMODEM_PROXY_EXCEPTIONS", "frogfind.com,theoldnet.com,68k.news")
    exceptions = html.escape("\n".join(value for value in re.split(r"[\s,]+", values)
                                        if value and value.lower().strip(".") != "retroweb.bjrno.com"))
    option = lambda value, label: f'<option value="{value}" {"selected" if mode == value else ""}>{label}</option>'
    return f'''<section class="card" id="webproxy"><h2>{tr(language,'Webproxy','Web proxy')}</h2>
<p>{tr(language,'RetroModem gebruikt de publieke RetroWEB-proxy op <code>retroweb.bjrno.com:8081</code>. Er draait geen inhoudsproxy op het modem zelf.','RetroModem uses the public RetroWEB proxy at <code>retroweb.bjrno.com:8081</code>. No content proxy runs on the modem itself.')}</p>
<form method="post" action="/settings/proxy"><input type="hidden" name="csrf" value="{{{{csrf}}}}">
<label>{tr(language,'Proxystand','Proxy mode')}</label><select id="proxy-mode" name="mode">{option('manual',tr(language,'Handmatig — instellen in browser','Manual — configure in browser'))}{option('automatic',tr(language,'Automatisch — via retroweb.bjrno.com','Automatic — through retroweb.bjrno.com'))}</select>
<div class="notice" data-mode="manual"><strong>{tr(language,'Handmatig','Manual')}</strong><p>{tr(language,'RetroModem stuurt het verkeer in deze stand niet om. Stel zelf een HTTP-proxy naar keuze in de retrobrowser in. Voor RetroWEB gebruik je <code>retroweb.bjrno.com</code>, poort <code>8081</code>, zonder gebruikersnaam of wachtwoord.','RetroModem does not redirect traffic in this mode. Configure an HTTP proxy of your choice in the retro browser. To use RetroWEB, enter <code>retroweb.bjrno.com</code>, port <code>8081</code>, without a username or password.')}</p></div>
<div class="notice" data-mode="automatic"><strong>{tr(language,'Automatisch','Automatic')}</strong><p>{tr(language,'Laat de proxy-instelling in de retrobrowser uit. RetroModem stuurt HTTP-verkeer automatisch via <code>retroweb.bjrno.com:8081</code>.','Disable proxy settings in the retro browser. RetroModem automatically sends HTTP traffic through <code>retroweb.bjrno.com:8081</code>.')}</p></div>
<div class="notice"><strong>{tr(language,'Zoeken en webproxy','Search and web proxy')}</strong><p>{tr(language,'Open <a href="http://retroweb.bjrno.com/">retroweb.bjrno.com</a> als zoekmachine of om een webadres in te voeren. Dit werkt in beide standen.','Open <a href="http://retroweb.bjrno.com/">retroweb.bjrno.com</a> as a search engine or to enter a web address. This works in both modes.')}</p></div>
<fieldset id="automatic-settings"><legend>{tr(language,'Alleen voor automatisch','Automatic mode only')}</legend><label>{tr(language,'Uitzonderingen','Exceptions')}</label><textarea name="exceptions" rows="8" placeholder="example.com\nretro.example.org">{exceptions}</textarea><p class="helper">{tr(language,'Deze domeinen gaan rechtstreeks naar de website en niet via de publieke RetroWEB-proxy.','These domains connect directly to the website instead of using the public RetroWEB proxy.')}</p></fieldset>
<div class="notice warning"><strong>{tr(language,'Niet voor gevoelige gegevens.','Not for sensitive data.')}</strong> {tr(language,'De publieke proxy kan HTTP-verkeer lezen en wijzigen; gebruik hem niet voor wachtwoorden, accounts of betalingen.','The public proxy can read and modify HTTP traffic; do not use it for passwords, accounts or payments.')}</div>
<button class="primary" type="submit">{tr(language,'Proxy-instellingen opslaan','Save proxy settings')}</button></form>
<script>const pm=document.getElementById('proxy-mode'),automatic=document.getElementById('automatic-settings'),notes=document.querySelectorAll('[data-mode]');function proxyMode(){{automatic.disabled=pm.value!=='automatic';notes.forEach(n=>n.hidden=n.dataset.mode!==pm.value)}}pm.addEventListener('change',proxyMode);pm.form.addEventListener('submit',()=>automatic.disabled=false);proxyMode();</script></section>'''


def chatgpt_settings_card(language: str, config: dict[str, str]) -> str:
    status = openai_auth.connection_status()
    continues = config.get("RETROMODEM_CHATGPT_CONTINUE", "0") == "1"
    allows_agent = config.get("RETROMODEM_CHATGPT_AGENT", "0") == "1"
    if status["connected"]:
        account = html.escape(str(status["email"] or tr(language, "Verbonden account", "Connected account")))
        action = f"""<div class="notice status-row" style="flex-wrap:wrap;margin-bottom:18px"><div><strong>{tr(language,'Verbonden','Connected')}</strong>{account}</div>
<form method="post" action="/openai/disconnect" style="margin:0"><input type="hidden" name="csrf" value="{{{{csrf}}}}"><button class="danger" style="margin:0" type="submit">{tr(language,'ChatGPT loskoppelen','Disconnect ChatGPT')}</button></form></div>
<p>{tr(language,'Bel <code>5559999</code> voor ChatGPT met webzoeken, of gebruik de webversie hieronder.','Dial <code>5559999</code> for ChatGPT with web search, or use the web version below.')}</p>"""
    else:
        action = f"""<p>{tr(language,'Verbind een ChatGPT Plus- of Pro-account zonder API-key. De toestemming geldt alleen voor antwoorden via de Responses API en geeft geen toegang tot je bestaande ChatGPT-gesprekken.','Connect a ChatGPT Plus or Pro account without an API key. Permission applies only to Responses API answers and does not expose your existing ChatGPT conversations.')}</p>
<form method="post" action="/openai/start"><input type="hidden" name="csrf" value="{{{{csrf}}}}"><button class="primary" type="submit">Continue with ChatGPT</button></form>"""
    conversation = f"""<form class="form-section" method="post" action="/settings/chatgpt"><input type="hidden" name="csrf" value="{{{{csrf}}}}"><input type="hidden" name="continue_conversation" value="0"><input type="hidden" name="allow_agent" value="0"><label><input name="continue_conversation" type="checkbox" value="1" style="width:auto;min-height:auto" {'checked' if continues else ''}> {tr(language,'Gesprek voortzetten tussen oproepen','Continue conversation between calls')}</label><small class="helper">{tr(language,'Uit: iedere oproep begint een nieuw gesprek. Aan: de geschiedenis blijft in het geheugen tot /new, een herstart of het uitschakelen van deze optie.','Off: every call starts a new conversation. On: history remains in memory until /new, a restart, or disabling this option.')}</small><label><input name="allow_agent" type="checkbox" value="1" style="width:auto;min-height:auto" {'checked' if allows_agent else ''}> {tr(language,'Netwerkagent toestaan','Allow network agent')}</label><small class="helper">{tr(language,'Geeft ChatGPT netwerktools voor DNS, ping, poorttests, HTTP/API en SSH. Voor wijzigende acties vraagt de terminal eerst ja/nee.','Gives ChatGPT network tools for DNS, ping, port checks, HTTP/API and SSH. The terminal asks yes/no before mutating actions.')}</small><button type="submit">{tr(language,'ChatGPT-opties opslaan','Save ChatGPT options')}</button></form>"""
    web_help = tr(language, 'Open <a href="http://chatgpt.retromodem">http://chatgpt.retromodem</a> voor de webversie, ook zonder proxyinstelling. Werkt met eenvoudige HTML-formulieren, zonder JavaScript of cookies. Gesprekken blijven maximaal een uur in het geheugen; een herstart wist ze. Kies Nieuw gesprek om opnieuw te beginnen. Verbind PPP opnieuw als de naam nog niet wordt gevonden.', 'Open <a href="http://chatgpt.retromodem">http://chatgpt.retromodem</a> for the web version, also without a configured proxy. Uses basic HTML forms without JavaScript or cookies. Conversations remain in memory for up to one hour; restarting clears them. Select New conversation to start again. Reconnect PPP if the name cannot be resolved.')
    conversation = conversation.replace('Gesprek voortzetten tussen oproepen', 'Gesprek voortzetten in web en BBS').replace('Continue conversation between calls', 'Continue conversation in web and BBS')
    conversation = conversation.replace('Uit: iedere oproep begint een nieuw gesprek. Aan: de geschiedenis blijft in het geheugen tot /new, een herstart of het uitschakelen van deze optie.', 'Uit: iedere oproep of nieuw geopende webpagina begint een nieuw gesprek. Aan: web en BBS hervatten hetzelfde gesprek tot Nieuw gesprek, /new, een reboot of het uitschakelen van deze optie. Bij lange gesprekken vervallen de oudste berichten.')
    conversation = conversation.replace('Off: every call starts a new conversation. On: history remains in memory until /new, a restart, or disabling this option.', 'Off: each call or newly opened web page starts a new conversation. On: web and BBS resume the same conversation until New conversation, /new, a reboot, or disabling this option. Long conversations drop the oldest messages.')
    conversation = conversation.replace('Voor wijzigende acties vraagt de terminal eerst ja/nee.', 'Voor wijzigende acties vraagt de terminal of webpagina eerst ja/nee.').replace('The terminal asks yes/no before mutating actions.', 'The terminal or web page asks yes/no before mutating actions.')
    conversation = conversation.replace('netwerktools voor DNS, ping, poorttests, HTTP/API en SSH.', 'netwerktools voor het vinden van apparaten, lokale poortscans, DNS, ping, traceroute, HTTP/API en SSH.').replace('network tools for DNS, ping, port checks, HTTP/API and SSH.', 'network tools for device discovery, local port scans, DNS, ping, traceroute, HTTP/API and SSH.')
    web_help = web_help.replace('Gesprekken blijven maximaal een uur in het geheugen; een herstart wist ze.', 'Of een gesprek bij opnieuw openen wordt hervat, stel je hieronder in.').replace('Conversations remain in memory for up to one hour; restarting clears them.', 'The option below controls whether reopening resumes the conversation.')
    heading = tr(language, "ChatGPT · web en BBS 5559999", "ChatGPT · web and BBS 5559999")
    return f"""<section class="card" id="chatgpt"><h2>{heading}</h2>{action}<p>{web_help}</p>{conversation}</section>"""


def phonebook_page(language: str) -> str:
    """Render fixed dial-up services and the editable public BBS directory."""
    entries = load_phonebook()
    bbs_cards = ""
    for entry in entries:
        if str(entry.get("kind", "bbs")) != "bbs":
            continue
        number = html.escape(str(entry.get("number", "")), quote=True)
        label = html.escape(str(entry.get("label", "")), quote=True)
        host = html.escape(str(entry.get("host", "")), quote=True)
        port = html.escape(str(entry.get("port", "23")), quote=True)
        bbs_cards += f"""<form class="card phone-entry bbs-entry" method="post" action="/phonebook/update">
<input type="hidden" name="csrf" value="{{{{csrf}}}}"><input type="hidden" name="original_number" value="{number}">
<input type="hidden" name="kind" value="bbs">
<div><label>{tr(language,'Nummer','Number')}</label><input name="number" inputmode="tel" value="{number}" required></div>
<div><label>{tr(language,'Naam','Name')}</label><input name="label" value="{label}" required></div>
<div><label>Host</label><input name="host" value="{host}" required></div><div><label>Port</label><input name="port" type="number" min="1" max="65535" value="{port}" required></div>
<div class="entry-actions"><button name="action" value="save" type="submit">{tr(language,'Opslaan','Save')}</button><button class="danger" name="action" value="delete" type="submit">{tr(language,'Verwijderen','Delete')}</button></div></form>"""
    connected = bool(openai_auth.connection_status()["connected"])
    chat_status = (f'<span class="chip ok">{tr(language,"Verbonden","Connected")}</span>' if connected
                   else f'<span class="chip warn">{tr(language,"Niet verbonden","Not connected")}</span>')
    return f"""<div class="page-heading"><h1>{tr(language,'Telefoonboek','Phone book')}</h1><p>{tr(language,'Alle nummers voor inbelinternet, publieke BBS’en en ChatGPT.','All numbers for dial-up internet, public BBSes and ChatGPT.')}</p></div>
<h2 class="section-heading">{tr(language,'Systeemnummers','System numbers')}</h2>
<div class="grid"><section class="card"><h2>{tr(language,'Inbelinternet','Dial-up internet')} · 5559000</h2><dl><dt>{tr(language,'Gebruikersnaam','Username')}</dt><dd><code>user</code></dd><dt>{tr(language,'Wachtwoord','Password')}</dt><dd>{tr(language,'Leeg laten','Leave blank')}</dd><dt>IP / DNS</dt><dd>{tr(language,'Automatisch','Automatic')}</dd></dl></section>
<section class="card"><div class="status-row"><div><h2>ChatGPT · 5559999</h2><small>{tr(language,'Chat met webzoeken; nieuw gesprek of voortzetten is instelbaar.','Chat with web search; starting new or continuing is configurable.')}</small></div>{chat_status}</div><div class="actions"><a class="button primary" href="/settings#chatgpt">{tr(language,'ChatGPT-autorisatie en gespreksmodus','ChatGPT authorization and conversation mode')}</a></div></section></div>
<h2 class="section-heading">{tr(language,'BBS-nummers','BBS numbers')} · 5551000–…</h2>{bbs_cards}
<section class="card"><h2>{tr(language,'BBS toevoegen','Add BBS')}</h2><form method="post" action="/phonebook/add"><input type="hidden" name="csrf" value="{{{{csrf}}}}">
<label>{tr(language,'Telefoonnummer','Phone number')}</label><input name="number" inputmode="tel" placeholder="5551010" required>
<label>{tr(language,'Naam','Name')}</label><input name="label" placeholder="Nieuwe BBS" required>
<input type="hidden" name="kind" value="bbs"><label>Host</label><input name="host" placeholder="bbs.example.net" required><label>Port</label><input name="port" type="number" min="1" max="65535" value="23" required>
<button type="submit">{tr(language,'Toevoegen','Add')}</button></form></section>"""


def page(title: str, body: str, language: str, csrf: str, refresh: int | None = None) -> bytes:
    refresh_tag = f'<meta http-equiv="refresh" content="{refresh}">' if refresh else ""
    nav_items = [
        ("/", "Status", "Status"),
        ("/modem", tr(language, "Verbinding", "Connection"), "Modem"),
        ("/transfer", tr(language, "Bestandsoverdracht", "File transfer"), tr(language, "Bestandsoverdracht", "File transfer")),
        ("/files", tr(language, "Bestandsbibliotheek", "File library"), tr(language, "Bestandsbibliotheek", "File library")),
        ("/phonebook", tr(language, "Telefoonboek", "Phone book"), tr(language, "Telefoonboek", "Phone book")),
        ("/wifi", "Wi-Fi", "Wi-Fi"),
        ("/settings", tr(language, "Instellingen", "Settings"), tr(language, "Instellingen", "Settings")),
        ("/guides", tr(language, "Handleidingen", "Guides"), tr(language, "Handleidingen", "Guides")),
    ]
    navigation = "".join(
        f'<a href="{href}" class="{"current" if match == title else ""}" {"aria-current=page" if match == title else ""}>{label}</a>'
        for href, label, match in nav_items
    )
    document = f"""<!doctype html>
<html lang="{language}"><head><meta charset="utf-8"><meta name="viewport" content="width=device-width,initial-scale=1">
{refresh_tag}<title>{html.escape(title)} · RetroModem</title>
<style>
:root{{--ink:#18303e;--muted:#61727b;--paper:#fff;--card:#fff;--canvas:#eef2f2;--sky:#dcebf0;--accent:#eb7146;--accent-dark:#d95d35;--green:#3f9f75;--amber:#b7791f;--red:#b63e3e;--line:#cbd6d9;--graphite:#123d55;--navy-2:#1d5874;--shadow:0 18px 50px rgba(21,49,62,.10)}}
*{{box-sizing:border-box}}body{{margin:0;min-height:100vh;background:var(--canvas);color:var(--ink);font:16px/1.5 Inter,ui-sans-serif,system-ui,-apple-system,BlinkMacSystemFont,"Segoe UI",sans-serif}}
header{{height:78px;background:var(--paper);color:var(--graphite);padding:0 max(24px,calc((100% - 1160px)/2));border-bottom:1px solid #d7e0e2;display:flex;flex-direction:column;justify-content:center}}header h1{{margin:0;font-size:1.2rem;letter-spacing:-.02em;color:var(--graphite)}}header h1:before{{content:"";display:inline-block;width:7px;height:20px;margin-right:10px;border-radius:2px;background:var(--accent);vertical-align:-3px;transform:skewY(-20deg)}}header small{{color:var(--muted);font-size:.72rem;margin-left:21px}}main{{max-width:1160px;margin:0 auto;padding:0 24px 80px}}
nav{{display:flex;gap:0;overflow-x:auto;margin:0 0 38px;padding:0;background:var(--paper);position:sticky;top:0;z-index:5;border-bottom:1px solid var(--line);box-shadow:0 5px 18px rgba(21,49,62,.04)}}nav a,.button,button{{border:0;border-radius:8px;background:var(--graphite);color:#fff;min-height:42px;padding:.78rem 1rem;text-decoration:none;cursor:pointer;font-size:.86rem;font-weight:700;line-height:1;white-space:nowrap;display:inline-flex;align-items:center;justify-content:center;transition:.18s ease}}nav a{{position:relative;border-radius:0;background:transparent;color:var(--muted);font-size:.78rem;font-weight:800}}nav a:hover{{background:var(--sky);color:var(--graphite)}}nav a.current{{background:transparent;color:var(--graphite)}}nav a.current:after{{content:"";position:absolute;left:14px;right:14px;bottom:0;height:3px;border-radius:3px 3px 0 0;background:var(--accent)}}a:focus-visible,button:focus-visible,input:focus-visible,select:focus-visible,summary:focus-visible{{outline:3px solid rgba(29,88,116,.25);outline-offset:2px}}button:disabled,.button.disabled{{opacity:.55;cursor:not-allowed}}
.page-heading{{margin:0 0 28px;padding:0 2px}}.page-heading:before{{content:"RETROMODEM";display:block;margin-bottom:7px;color:var(--accent);font-size:.7rem;font-weight:900;letter-spacing:.14em}}.page-heading h1{{font-size:clamp(2rem,4vw,3.4rem);line-height:1;letter-spacing:-.045em;margin:0 0 10px;color:var(--graphite)}}.page-heading p{{color:var(--muted);margin:0;max-width:70ch;line-height:1.65}}.section-heading{{margin:34px 0 12px;color:var(--graphite);font-size:1.25rem}}.grid{{display:grid;grid-template-columns:repeat(auto-fit,minmax(280px,1fr));gap:16px}}.card{{background:var(--card);border:1px solid var(--line);border-radius:16px;padding:24px;box-shadow:var(--shadow)}}main>.card+*,main>.grid+*,main>.notice+*,main>.page-heading+*{{margin-top:16px}}main>.section-heading+*{{margin-top:0}}.card>:first-child{{margin-top:0}}.card>:last-child{{margin-bottom:0}}h2{{color:var(--graphite);font-size:1.16rem;margin:0 0 14px;letter-spacing:-.01em}}h3{{color:var(--graphite);font-size:1rem;line-height:1.3;margin:22px 0 8px}}p{{margin:0 0 14px}}dl{{display:grid;grid-template-columns:auto 1fr;gap:8px 14px;margin:0}}dt{{color:var(--muted)}}dd{{margin:0;font-weight:650;overflow-wrap:anywhere}}.ok{{color:var(--green)}}.bad{{color:var(--red)}}
.hero{{display:grid;grid-template-columns:1fr auto;gap:18px;align-items:center;background:var(--graphite);color:#fff;border:0;margin-bottom:16px;box-shadow:0 18px 50px rgba(21,49,62,.18)}}.hero h2{{color:#fff;font-size:1.45rem;margin-bottom:5px}}.hero p{{margin:0;color:#c5d5dc}}.route{{font:700 .96rem ui-monospace,SFMono-Regular,Consolas,monospace;color:#fff!important;margin-top:12px!important}}.dashboard{{display:grid;grid-template-columns:repeat(12,1fr);gap:16px}}.span-12{{grid-column:span 12}}.span-8{{grid-column:span 8}}.span-6{{grid-column:span 6}}.span-4{{grid-column:span 4}}
.chip{{display:inline-flex;align-items:center;gap:6px;border-radius:999px;padding:4px 9px;background:#e9edef;color:#405159;font-size:.78rem;font-weight:800}}.chip:before{{content:"";width:7px;height:7px;border-radius:50%;background:#829198}}.chip.ok{{background:#e4f4eb;color:#176641}}.chip.ok:before{{background:var(--green)}}.chip.active{{background:#dceff1;color:#145d66}}.chip.active:before{{background:#247f89}}.chip.bad{{background:#f8e7e7;color:#8d2f2f}}.chip.bad:before{{background:var(--red)}}.chip.warn{{background:#fbf0d8;color:#875c17}}.chip.warn:before{{background:var(--amber)}}
.status-list{{display:grid;gap:0}}.status-row{{display:flex;align-items:center;justify-content:space-between;gap:12px;min-height:52px;padding:11px 0;border-bottom:1px solid #e3e9ea}}.status-row:last-child{{border-bottom:0}}.status-row>div:first-child{{min-width:0}}.status-row strong{{display:block}}.status-row small{{display:block;color:var(--muted)}}.status-row code{{font-size:.86rem}}.actions{{display:flex;gap:9px;flex-wrap:wrap}}.card>.actions{{margin-top:18px;padding-top:16px;border-top:1px solid var(--line)}}.card>.status-row+.actions{{margin-top:0}}.card>.status-row{{border-bottom:0}}.actions .button,.button.secondary{{background:transparent;color:var(--graphite);border:1px solid #b8c8cd;box-shadow:none}}.actions .button.primary,.button.primary,button.primary{{background:var(--accent);color:#fff;border:0}}.button.danger,button.danger{{background:#a33;color:#fff}}.button.ghost,button.ghost{{background:transparent;color:var(--graphite);border:1px solid var(--line);box-shadow:none}}
label{{display:block;color:var(--graphite);font-size:.8rem;font-weight:800;margin:16px 0 7px}}input,select{{width:100%;min-height:44px;padding:.78rem .85rem;border:1px solid #bfcdd1;border-radius:7px;background:#fbfcfc;color:var(--ink);font:inherit;outline:none}}input:focus,select:focus{{border-color:var(--navy-2);box-shadow:0 0 0 3px rgba(29,88,116,.1);background:#fff}}button{{margin-top:18px;background:var(--accent);box-shadow:0 7px 18px rgba(235,113,70,.18)}}button:hover,.button:hover{{transform:translateY(-1px)}}.helper{{display:block;color:var(--muted);font-size:.84rem;margin-top:6px}}.form-section{{background:color-mix(in srgb,var(--sky) 55%,#fff);border:1px solid var(--line);border-radius:12px;padding:18px;margin-top:20px}}.form-section h3{{margin-top:0}}details.hardware,details.guide-help{{margin-top:18px;padding-top:14px;border-top:1px solid var(--line)}}summary{{cursor:pointer;font-weight:800;color:var(--graphite)}}.guide-tabs{{display:flex;gap:7px;flex-wrap:wrap}}.guide-tabs button{{margin:0;background:transparent;color:var(--graphite);border:1px solid #b8c8cd;border-radius:8px;box-shadow:none}}.guide-tabs button.active{{background:var(--sky);color:var(--graphite);border-color:#9fb6bf;box-shadow:inset 0 -3px 0 var(--accent)}}.guide-panel[hidden]{{display:none}}.guide-panel{{width:100%;max-width:none}}.verification{{display:flex;gap:8px;flex-wrap:wrap;margin:0 0 18px}}.verification span{{display:inline-flex;align-items:center;padding:5px 10px;border-radius:999px;font-size:.78rem;font-weight:800;background:var(--canvas);color:var(--muted);border:1px solid var(--line)}}.verification .verified{{background:#e4f2eb;color:#246343;border-color:#b7dbc8}}.verification .experimental{{background:#fff2d9;color:#79520d;border-color:#edd19a}}.verification .unsupported{{background:#f9e5e1;color:#8b3428;border-color:#e8bab1}}
#webproxy form>h3{{margin-top:32px;padding-top:24px;border-top:1px solid var(--line)}}#webproxy form>h3:first-of-type{{margin-top:20px;padding-top:0;border-top:0}}#webproxy fieldset{{margin:18px 0 26px;padding:0;border:0}}#webproxy fieldset h3,#webproxy fieldset h4{{margin-top:28px;margin-bottom:10px}}#webproxy .notice{{margin:14px 0 20px}}#manual-proxy-settings{{margin:18px 0 28px;padding:16px 18px;border:1px solid var(--line);border-radius:10px;background:var(--canvas)}}#manual-proxy-settings h3{{margin-top:0}}#webproxy textarea{{width:100%;padding:.78rem .85rem;border:1px solid #bfcdd1;border-radius:7px;background:#fbfcfc;color:var(--ink);font:inherit}}.proxy-image-dimensions{{margin:4px 0 24px}}
.phone-entry{{display:grid;grid-template-columns:1fr 2fr 2fr 110px;gap:0 12px;margin-bottom:12px}}.entry-actions{{display:flex;gap:8px;grid-column:1/-1}}.bbs-entry{{grid-template-columns:110px minmax(140px,1.2fr) minmax(170px,1.5fr) 85px auto;padding:7px 9px;gap:7px;align-items:center;box-shadow:none;margin-bottom:5px}}.bbs-entry label{{display:none}}.bbs-entry input,.bbs-entry select{{padding:6px 7px}}.bbs-entry .entry-actions{{grid-column:auto;gap:5px}}.bbs-entry button{{margin:0;padding:7px 9px;font-size:.82rem;min-height:38px}}table{{width:100%;border-collapse:collapse}}th,td{{padding:9px 6px;border-bottom:1px solid var(--line);text-align:left}}.notice{{padding:13px 15px;border-left:4px solid var(--green);border-radius:0 10px 10px 0;background:#e9f5ed}}.warning{{border-color:var(--amber);background:#fbf0dd}}.transfer-status{{display:grid;grid-template-columns:auto 1fr auto;gap:12px;align-items:center}}.transfer-status button{{margin:0}}.status-icon{{font-size:1.5rem}}.status-title{{font-weight:750}}.status-meta{{color:var(--muted);font-size:.9rem}}.progress{{height:9px;background:#d7d0c4;border-radius:9px;overflow:hidden;margin-top:10px}}.progress>span{{display:block;height:100%;width:35%;background:var(--green);border-radius:9px}}.progress.running>span{{animation:scan 1.25s ease-in-out infinite}}@keyframes scan{{0%{{transform:translateX(-110%)}}100%{{transform:translateX(310%)}}}}.technical{{margin-top:10px}}.technical pre{{white-space:pre-wrap;max-height:120px;overflow:auto;font-size:.78rem}}.file-list{{display:grid;gap:8px;margin:0;padding:0;list-style:none}}.file-list li{{display:flex;align-items:center;justify-content:space-between;gap:12px;padding:10px 0;border-bottom:1px solid var(--line)}}.file-list li:last-child{{border:0}}code{{background:#e8e3da;padding:2px 5px;border-radius:5px}}ol.steps{{padding-left:1.4rem}}ol.steps>li{{margin:0 0 18px;padding-left:5px}}ul.compact{{margin:6px 0}}
.received-files{{padding-block:18px}}.received-files>p{{margin-bottom:6px}}.file-list li{{padding:7px 0}}.file-actions{{display:flex;align-items:center;gap:6px}}.file-actions form{{margin:0}}.file-actions .button,.file-actions button{{margin:0;padding:7px 10px;min-height:36px;font-size:.82rem}}
.content-stack{{display:flex;flex-direction:column;gap:24px}}.content-stack> *{{margin-block:0!important}}.content-stack>[hidden]{{display:none}}.card:not(.content-stack)>.notice+*{{margin-top:24px}}.software-list{{display:grid;gap:16px}}.software-card{{display:grid;grid-template-columns:minmax(0,1fr) 210px;gap:20px;align-items:center;padding:16px;border:1px solid var(--line);border-radius:12px;background:#f9f7f2}}.software-card h3{{margin:0 0 5px}}.software-card p{{margin:0}}.software-actions{{display:grid;gap:7px;width:210px}}.software-actions form{{margin:0;width:100%}}.software-actions .button,.software-actions button{{margin:0;width:100%}}.guide-images{{display:grid;grid-template-columns:repeat(auto-fit,minmax(260px,1fr));gap:12px;margin:14px 0 20px}}.guide-images figure{{margin:0;border:1px solid var(--line);border-radius:10px;overflow:hidden;background:#f7f8f8}}.guide-images img{{display:block;width:100%;height:auto;image-rendering:auto}}.guide-images figcaption{{padding:9px 11px;color:var(--muted);font-size:.8rem}}
@media(max-width:850px){{.span-8,.span-6,.span-4{{grid-column:span 12}}.bbs-entry{{grid-template-columns:100px 1fr 1fr 80px}}.bbs-entry .entry-actions{{grid-column:1/-1}}}}@media(max-width:720px){{.phone-entry,.bbs-entry{{grid-template-columns:1fr 1fr;padding:16px}}.bbs-entry label{{display:block}}.bbs-entry>div:nth-of-type(2),.bbs-entry>div:nth-of-type(3){{grid-column:1/-1}}.guide-tabs{{flex-wrap:nowrap;overflow-x:auto;padding-bottom:6px}}}}@media(max-width:520px){{main{{padding-inline:12px;padding-bottom:52px}}header{{height:64px;padding-inline:16px}}header small,.page-heading:before{{display:none}}nav{{margin-inline:-12px;margin-bottom:26px;padding-inline:4px}}nav a{{min-height:46px;padding-inline:12px}}.page-heading h1{{font-size:2.25rem}}.card{{padding:19px}}.hero{{grid-template-columns:1fr}}.hero .button{{width:100%}}.phone-entry,.bbs-entry,.transfer-status,.software-card{{grid-template-columns:1fr}}.software-actions{{width:100%}}.bbs-entry>div{{grid-column:1!important}}dl{{grid-template-columns:minmax(90px,auto) 1fr}}dd{{margin-bottom:7px}}.transfer-status form,.transfer-status button{{width:100%}}.actions .button{{flex:1 1 100%}}}}
@media(prefers-reduced-motion:reduce){{.progress.running>span{{animation:none;width:100%;opacity:.65}}}}
</style></head><body>
<header><h1>RetroModem</h1><small>{tr(language,'Wi-Fi-bridge voor klassieke computers en handhelds','Wi-Fi bridge for classic computers and handhelds')}</small></header>
<main><nav>{navigation}</nav>{body}</main>
</body></html>"""
    return document.encode("utf-8")


def irda_speed_guide(language: str, device: str) -> str:
    tested = {
        "generic": tr(language, "MY018: PPP op 57k6 getest met Palm IIIc/OS 4.1 en Psion 5mx; Palm Beam naar de Palm ook getest. Andere apparaten zijn daarmee niet automatisch getest.", "MY018: 57.6k PPP tested with Palm IIIc/OS 4.1 and Psion 5mx; Beam to Palm also tested. Other devices are not automatically verified."),
        "psion": tr(language, "MY018: PPP op de Psion 5mx werkt op 57k6. EPOC- en terminalbestandsoverdracht zijn met deze nieuwe module nog niet opnieuw geverifieerd; de eerdere beperkingen blijven dus gelden.", "MY018: PPP on Psion 5mx works at 57.6k. EPOC and terminal transfers have not been reverified with this new module; the previous limitations still apply."),
        "palm-new": tr(language, "MY018 + Palm IIIc/OS 4.1: PPP en een volledige Beam-overdracht naar de Palm werken op 57k6. Gemeten: 79.026 bytes in 23,91 s, gemiddeld 3,305 kB/s inclusief verbinden. Beam vanaf de Palm was eerder op 9600 getest; op 57k6 nog niet.", "MY018 + Palm IIIc/OS 4.1: PPP and a complete Beam transfer to Palm work at 57.6k. Measured: 79,026 bytes in 23.91 s, averaging 3.305 kB/s including connection. Beam from Palm was previously tested at 9600, not yet at 57.6k."),
    }
    return f'<div class="form-section"><h3>{tr(language,"IrDA-snelheid per adapter","IrDA speed by adapter")}</h3><p>{tested[device]}</p><ul><li><strong>MY018:</strong> {tr(language,"57k6 is de aanbevolen geteste instelling, uitsluitend met de aangepaste A/B/C-bedrading en transistorschakeling. 19k2 is gedeeltelijk getest; 38k4 nog niet.","57.6k is the recommended tested setting, only with the modified A/B/C wiring and transistor switch. 19.2k is partially tested; 38.4k is untested.")}</li><li><strong>MA-620:</strong> {tr(language,"gebruik de bewezen 9600-instelling van deze USB-adapter; de MY018-resultaten gelden hier niet voor.","use this USB adapter’s verified 9600 setting; MY018 results do not apply.")}</li></ul><p class="notice warning"><strong>115k2:</strong> {tr(language,"experimenteel, niet stabiel aangetoond. Palm Beam kon in onze tests niet verbinden; Psion PPP is niet bevestigd. Dit is geen algemene IrDA-beperking. Ga bij problemen terug naar 57k6 of 9600.","experimental, not proven stable. Palm Beam failed to connect in our tests; Psion PPP is unconfirmed. This is not a general IrDA limitation. Fall back to 57.6k or 9600 if needed.")}</p><p>{tr(language,"Kies het maximum op","Select the maximum on")} <a href="/modem">{tr(language,"de Modem-pagina","the Modem page")}</a>. {tr(language,"Ontdekking begint altijd op 9600, daarna volgt de onderhandelde snelheid. Een connection-instelling op het apparaat bewijst de fysieke linksnelheid niet; Beam en PPP kunnen hun eigen instellingen gebruiken. Verbreek en verbind opnieuw na een wijziging.","Discovery always starts at 9600, then the negotiated speed follows. A device connection preference does not prove the physical speed; Beam and PPP can use their own settings. Disconnect and reconnect after a change.")}</p></div>'


def general_guide(language: str) -> str:
    """Shared workflow; device panels only supply their specific setup."""
    t = lambda nl, en: tr(language, nl, en)
    sections = [
        (t('1. Sluit je apparaat aan', '1. Connect your device'),
         t('Voor infrarood heeft <strong>MY018 via GPIO/UART</strong> de voorkeur: 57600 bit/s met de aangepaste A/B/C-bedrading en transistorschakeling. <strong>MA-620 via USB</strong> is de infraroodfallback op 9600 bit/s. Richt de IR-poorten op elkaar. Voor computers zonder IR gebruik je <strong>Prolific USB-naar-RS-232</strong>, met de juiste apparaatkabel en zo nodig een null-modemadapter. Kies de adapter op de <a href="/modem">Modem-pagina</a>.',
           'For infrared, <strong>MY018 through GPIO/UART</strong> is preferred: 57600 bps with the modified A/B/C wiring and transistor circuit. <strong>MA-620 through USB</strong> is the infrared fallback at 9600 bps. Align the IR ports. For computers without IR use <strong>Prolific USB-to-RS-232</strong>, with the correct device cable and a null-modem adapter if needed. Select the adapter on the <a href="/modem">Modem page</a>.')),
        (t('2. Kies de verbindingsmodus', '2. Choose the connection mode'),
         t('<strong>Direct internet (PPP):</strong> het apparaat start PPP zonder te bellen. <strong>Inbelmodem (Dial-Up) en BBS:</strong> het apparaat gebruikt AT-commando’s; bel <code>5559000</code> voor internet of een nummer uit het <a href="/phonebook">Telefoonboek</a> voor een BBS. Alleen “online” in een terminal is nog geen internetverbinding: daarvoor moet PPP actief zijn. Sluit de internetverbinding voordat je dezelfde poort voor een terminal of bestandsoverdracht gebruikt.',
           '<strong>Direct internet (PPP):</strong> the device starts PPP without dialling. <strong>Dial-up modem and BBS:</strong> the device uses AT commands; dial <code>5559000</code> for internet or a number from the <a href="/phonebook">Phone book</a> for a BBS. Being “online” in a terminal is not yet an internet connection: PPP must be active. Disconnect internet before using the same port for a terminal or file transfer.')),
        (t('3. Stel het retroapparaat in', '3. Configure the retro device'),
         t('Kies hierboven je apparaat voor de precieze stappen en teststatus. PPP gebruikt naam <code>user</code>, een leeg wachtwoord en automatische IP/DNS-toewijzing. Werkt dat op de Palm niet, gebruik dan eigen IP <code>192.168.77.2</code> en voor beide DNS-velden <code>192.168.77.1</code>. Gebruik RetroModem als DNS-server: publieke DNS kent de lokale .retromodem-adressen niet. De virtuele Hayes-poort staat op nieuwe installaties standaard op 115200 bit/s; bestaande keuzes blijven behouden. Dat is niet de fysieke MY018-linksnelheid van 57600 bit/s. Bij RS-232 moeten de seriële snelheden aan beide kanten overeenkomen.',
           'Choose your device above for exact steps and test status. PPP uses name <code>user</code>, a blank password and automatic IP/DNS assignment. If that fails on Palm, use device IP <code>192.168.77.2</code> and <code>192.168.77.1</code> for both DNS fields. Use RetroModem as DNS server: public DNS does not know the local .retromodem addresses. New installations default to 115200 bps for the virtual Hayes port; existing choices are preserved. This is not the physical MY018 link speed of 57600 bps. With RS-232, serial speeds must match at both ends.')),
        (t('4. Begin bij de lokale startpagina', '4. Open the local start page'),
         t('Open <a href="http://start.retromodem/">http://start.retromodem/</a> in de retrobrowser, met <strong>http://</strong> en niet https://. Daar staan Zoeken en ChatGPT bovenaan. Instellingen leidt naar <a href="http://setup.retromodem/">setup.retromodem</a>. De lokale pagina’s werken zonder browserproxy en ook via de ingebouwde proxy. Dit geldt voor direct PPP en voor PPP na inbellen op 5559000; niet iedere apparaat/route-combinatie is fysiek getest.',
           'Open <a href="http://start.retromodem/">http://start.retromodem/</a> in the retro browser, using <strong>http://</strong>, not https://. RetroWEB and ChatGPT are at the top. Settings opens <a href="http://setup.retromodem/">setup.retromodem</a>. Local pages work without a browser proxy. This applies to direct PPP and PPP after dialling 5559000; not every device/route combination has been physically tested.')),
        (t('5. Wifi en beheer', '5. Wi-Fi and administration'),
         t('Je kunt vanaf het retroapparaat zelf via <a href="http://wifi.retromodem/">wifi.retromodem</a> de huidige verbinding bekijken, netwerken scannen en een netwerk met wachtwoord kiezen. Hiervoor is geen internet nodig. Als de Pi geen bekend netwerk kan gebruiken, is de noodhotspot <code>retromodem</code> beschikbaar; verbind een telefoon of laptop en open <code>http://10.42.0.1</code>. Op je gewone netwerk staat de beheerinterface op <code>http://retromodem.local</code>. Start/Setup zijn de eenvoudige retro-ingang; proxy- en ChatGPT-accountinstellingen blijven in de beheerinterface.',
           'From the retro device itself, use <a href="http://wifi.retromodem/">wifi.retromodem</a> to view the current connection, scan networks and select a network with its password. Internet is not required. If the Pi cannot use a known network, the fallback hotspot <code>retromodem</code> is available; connect a phone or laptop and open <code>http://10.42.0.1</code>. On your normal network, administration is at <code>http://retromodem.local</code>. Start/Setup are the simple retro entry points; proxy and ChatGPT account settings remain in administration.')),
        (t('6. Zoeken, chatten en bestanden', '6. Search, chat and files'),
         t('<a href="http://retroweb.bjrno.com/">retroweb.bjrno.com</a> is de zoekmachine en publieke webproxy. <a href="http://chatgpt.retromodem/">chatgpt.retromodem</a> vereist eerst een gekoppeld account via Instellingen → ChatGPT in de beheerinterface. Voor beide is internet nodig. Voor BBS stuur je in een terminal <code>AT</code> + Enter (antwoord <code>OK</code>), gevolgd door <code>ATDT</code> en het nummer. ChatGPT BBS gebruikt <code>5559999</code>. <a href="/transfer">Bestandsoverdracht</a> biedt onder andere Palm Beam en terminalprotocollen; kies het protocol uit je apparaatgids.',
           '<a href="http://retroweb.bjrno.com/">retroweb.bjrno.com</a> is the search engine and public web proxy. <a href="http://chatgpt.retromodem/">chatgpt.retromodem</a> first requires linking an account under Settings → ChatGPT in administration. Both need internet. For a BBS, send <code>AT</code> + Enter in a terminal (reply <code>OK</code>), followed by <code>ATDT</code> and the number. ChatGPT BBS uses <code>5559999</code>. <a href="/transfer">File transfer</a> offers Palm Beam and terminal protocols, among others; choose the protocol in your device guide.')),
        (t('7. Problemen oplossen', '7. Troubleshooting'),
         t('Lokale naam niet gevonden? Controleer DNS 192.168.77.1 en verbind PPP opnieuw. Lokale pagina werkt maar internet niet? Controleer wifi; verbonden met wifi betekent niet automatisch dat internet werkt. Geen AT-antwoord? Controleer de Dial-Up-modus, adapter, uitlijning en virtuele/seriële snelheid; sluit andere programma’s die de poort gebruiken. Dubbele tekens? Zet lokale echo uit. Geheugen vol in de browser? Kies kleinere paginadelen of afbeeldingen als links. Een 403/429 kan een blokkade van de bronwebsite zijn; niet elke site kan lokaal worden opgehaald.',
           'Local name not found? Check DNS 192.168.77.1 and reconnect PPP. Local pages work but internet does not? Check Wi-Fi; Wi-Fi connectivity does not guarantee internet access. No AT reply? Check Dial-Up mode, adapter, alignment and virtual/serial speed; close other programs using the port. Duplicate characters? Disable local echo. Browser out of memory? Choose smaller page parts or images as links. A 403/429 may be a source-site restriction; not every site can be fetched locally.')),
    ]
    return ''.join('<h3>' + heading + '</h3><p>' + text + '</p>' for heading, text in sections)


def proxy_guide(language: str) -> str:
    t = lambda nl, en: tr(language, nl, en)
    return ('<p>' + t('RetroModem gebruikt de publieke RetroWEB-proxy op <code>retroweb.bjrno.com:8081</code> om moderne websites geschikt te maken voor oude browsers. De inhoudsverwerking draait niet op de Pi.', 'RetroModem uses the public RetroWEB proxy at <code>retroweb.bjrno.com:8081</code> to adapt modern websites for old browsers. Content processing does not run on the Pi.') + '</p>' +
            '<h3>' + t('Verbinding en browserinstelling', 'Connection and browser configuration') + '</h3><p>' +
            t('Maak eerst een PPP-verbinding, direct of via 5559000. In Handmatig stuurt RetroModem niets om en stel je zelf een HTTP-proxy naar keuze in de retrobrowser in. Voor RetroWEB gebruik je <code>retroweb.bjrno.com</code>, poort <code>8081</code>, zonder proxylogin. In Automatisch stuurt RetroModem HTTP-verkeer vanzelf naar deze publieke proxy; dan is geen browserproxy nodig. Lokale pagina’s zoals start.retromodem hebben geen browserproxy nodig.',
              'First establish PPP, directly or through 5559000. In Manual mode RetroModem does not redirect traffic; configure an HTTP proxy of your choice in the retro browser. To use RetroWEB, enter <code>retroweb.bjrno.com</code>, port <code>8081</code>, without proxy authentication. In Automatic mode RetroModem sends HTTP traffic to this public proxy automatically, so no browser proxy is needed. Local pages such as start.retromodem do not need a browser proxy.') + '</p>' +
            '<h3>' + t('Afbeeldingen en paginadelen', 'Images and page parts') + '</h3><p>' +
            t('Bovenaan een vereenvoudigde pagina kies je <strong>Afbeeldingen: Laten zien | Als links</strong>. Met links laad je afbeeldingen alleen wanneer je ze opent. In de beheerinterface kies je de startstand per sessie (laten zien, als links, of vorige sessie) en de afmetingen na conversie. De ingestelde paginagrootte is een schatting van HTML plus uitgepakte afbeeldingen na conversie, niet het aantal verzonden kilobytes. Met afbeeldingen als links telt alleen HTML voor de verdeling. Nieuwe installaties beginnen voorlopig op 250 kB; bestaande keuzes blijven behouden. Een kleiner budget is veiliger op apparaten met weinig geheugen. Er is geen vaste limiet van vijf afbeeldingen of vijf delen: grotere inhoud krijgt extra delen. Navigatie boven- en onderaan gaat naar het volgende deel.',
              'At the top of a simplified page choose <strong>Images: Inline | As links</strong>. Links load images only when you open them. Administration lets you choose the session starting mode (inline, links or previous session) and dimensions after conversion. The page-size setting estimates HTML plus decoded images after conversion, not transferred kilobytes. In image-link mode only HTML counts towards splitting. New installations currently start at 250 kB; existing choices are preserved. A smaller budget is safer on devices with little memory. There is no fixed limit of five images or five parts: larger content gets additional parts. Navigation at the top and bottom opens the next part.') + '</p>' +
            '<h3>' + t('Zoeken en uitzonderingen', 'Search and exceptions') + '</h3><p>' +
            t('Gebruik <a href="http://retroweb.bjrno.com/">retroweb.bjrno.com</a> als zoekmachine. In Handmatig kies en configureer je zelf een proxy; voor RetroWEB is dat deze host met poort <code>8081</code>. In Automatisch laat je de browserproxy uit; uitzonderingen stel je in de beheerinterface in.',
              'Use <a href="http://retroweb.bjrno.com/">retroweb.bjrno.com</a> as the search engine. In Manual mode choose and configure a proxy yourself; for RetroWEB use this host with port <code>8081</code>. In Automatic mode leave browser proxy settings off; configure exceptions in administration.') + '</p><p class="notice warning">' +
            t('Gebruik de webproxy niet voor wachtwoorden, accounts of betalingen. Hij herschrijft pagina’s en is geen volledige moderne browser. JavaScript-sites en bronblokkades kunnen onbruikbare inhoud of een fout opleveren. De lokale wifi- en chatpagina’s hebben hun eigen formulierafhandeling; dat maakt externe inlogformulieren niet geschikt.',
              'Do not use the web proxy for passwords, accounts or payments. It rewrites pages and is not a full modern browser. JavaScript sites and source restrictions may produce unusable content or errors. Local Wi-Fi and chat pages have their own form handling; this does not make external login forms suitable.') + '</p>')


def guides_page(language: str) -> str:
    """Device-oriented guides with transport and use-case kept separate."""
    body = f"""<div class="page-heading"><h1>{tr(language,'Handleidingen','Guides')}</h1><p>{tr(language,'Begin bij Algemeen, lees daarna de specifieke stappen voor je apparaat. Webproxy legt browsen, afbeeldingen en geheugen uit.','Start with General, then read the steps for your device. Web proxy explains browsing, images and memory.')}</p></div><section class="card"><h2>{tr(language,'Kies een onderwerp of apparaat','Choose a topic or device')}</h2><div class="guide-tabs">
<button type="button" data-guide="generic">{tr(language,'Algemeen','General')}</button><button type="button" data-guide="proxy">{tr(language,'Webproxy','Web proxy')}</button><button type="button" data-guide="psion">Psion 5mx</button><button type="button" data-guide="palm-old">Palm OS 3.0/3.1</button><button type="button" data-guide="palm-new">Palm OS 3.3–5.x</button><button type="button" data-guide="hp200lx">HP 200LX</button><button type="button" data-guide="win95">Windows 95</button><button type="button" data-guide="win98">Windows 98</button><button type="button" data-guide="winxp">Windows XP</button>
</div></section>
<section class="card guide-panel" id="generic" hidden><h2>{tr(language,'Algemene werkwijze','General workflow')}</h2>{general_guide(language)}</section>

<section class="card guide-panel" id="proxy" hidden><h2>{tr(language,'Ingebouwde webproxy','Built-in web proxy')}</h2>{proxy_guide(language)}</section>

<section class="card guide-panel" id="psion" hidden><h2>Psion Series 5mx</h2><div class="verification"><span class="verified">{tr(language,'Getest','Tested')} · IrDA PPP</span><span class="verified">{tr(language,'Getest','Tested')} · IrDA dial-up/BBS</span><span class="verified">{tr(language,'Getest','Tested')} · YMODEM</span><span class="experimental">{tr(language,'Experimenteel','Experimental')} · EPOC IR</span><span>{tr(language,'Niet getest','Not tested')} · USB-serieel</span></div><p><strong>IrDA:</strong> {tr(language,'getest met de 5mx.','tested with the 5mx.')} <strong>USB-serieel:</strong> {tr(language,'technisch geschikt met Psion-seriële kabel en de juiste adapter, maar nog niet fysiek getest.','technically suitable with a Psion serial cable and the appropriate adapter, but not yet physically tested.')}</p>
<h3>{tr(language,'Eerst voorbereiden','Prepare first')}</h3><ol><li><strong>{tr(language,'Zet Remote Link uit.','Disable Remote Link.')}</strong> {tr(language,'Open Instellingen, druk op de menuknop linksboven op de schermrand en kies Extra → Remote Link → Uit. Anders houdt synchronisatie de communicatiepoort bezet.','Open System, press the upper-left bezel menu button and select Tools → Remote Link → Off. Otherwise synchronization keeps the communications port occupied.')}</li></ol><div class="guide-images"><figure><img src="/static/guides/psion/setup-remote-link.gif" alt="{tr(language,'Psion-menu Extra met Remote Link geselecteerd','Psion Tools menu with Remote Link selected')}" loading="lazy"><figcaption>{tr(language,'Extra → Remote Link','Tools → Remote Link')}</figcaption></figure><figure><img src="/static/guides/psion/setup-internet-service.gif" alt="{tr(language,'Psion Remote Link-venster met Link op Uit','Psion Remote Link dialog with Link set to Off')}" loading="lazy"><figcaption>{tr(language,'Zet Link op Uit en bevestig met OK.','Set Link to Off and confirm with OK.')}</figcaption></figure></div><ol start="2"><li><strong>{tr(language,'Bevestig Bellen.','Confirm Dialling.')}</strong> {tr(language,'Open Configuratiescherm → Bellen (Engels: Dialling), open of selecteer de huidige instelling en sluit met OK. Doe dit ook als de standaardwaarden al goed lijken; anders verschijnt later de fout dat verbindings- of locatiegegevens ontbreken.','Open Control panel → Dialling, open or select the current setting and close with OK. Do this even if the defaults already look correct; otherwise applications may later report missing connection or location information.')}</li><li>{tr(language,'Mobile Connectivity Update 3.10 is optioneel. Probeer de ingebouwde netwerksoftware eerst; installeer de update alleen wanneer jouw EPOC-installatie verbindingsopties mist.','Mobile Connectivity Update 3.10 is optional. Try the built-in networking first; install the update only if your EPOC installation lacks connection options.')}</li></ol>
<h3>Direct PPP</h3><ol><li>{tr(language,'Kies op RetroModem de gewenste infraroodadapter en <strong>Direct PPP</strong>.','On RetroModem select the desired infrared adapter and <strong>Direct PPP</strong>.')}</li><li>{tr(language,'Open Configuratiescherm → Modems, maak een modem genaamd <em>RetroModem</em> en kies <strong>Infrarode mobiele telefoon</strong>. Gebruik voor MY018 de aanbevolen 57600 bit/s en voor MA-620 9600 bit/s. Bij USB-serieel kies je Serial en exact dezelfde snelheid als op de Modem-pagina.','Open Control panel → Modems, create a modem named <em>RetroModem</em> and select <strong>Infrared mobile phone</strong>. Use the recommended 57600 bps for MY018 and 9600 bps for MA-620. For USB serial, select Serial and exactly the same speed as on the Modem page.')}</li><li>{tr(language,'Tab Opties: laat de standaardwaarden staan. Tab Initialisatie: <code>AT</code>. Tab Geavanceerd: Hardware (RTS/CTS), Terminal detect en Carrier detect uit, Modemtype Vaste lijn.','Options tab: retain the defaults. Initialization tab: <code>AT</code>. Advanced tab: Hardware (RTS/CTS), Terminal detect and Carrier detect off, Modem type Fixed line.')}</li><li>{tr(language,'Open Configuratiescherm → Internet/Netwerk en maak een nieuwe dienst. Tab Dienst: een herkenbare naam, verbinding <strong>Direct</strong> en modem RetroModem. Tab Account: Handmatig aanmelden uit, gebruiker <code>user</code>, wachtwoord leeg.','Open Control panel → Internet/Network and create a new service. Service tab: a recognizable name, <strong>Direct</strong> connection and the RetroModem modem. Account tab: Manual login off, user <code>user</code>, blank password.')}</li><li>{tr(language,'Tab Adressen: IP-adres en DNS van server ophalen. Tab Login: standaard laten. Tab Geavanceerd: alleen <strong>platte tekst accepteren</strong> ingeschakeld. Er is geen telefoonnummer of loginscript nodig.','Addresses tab: obtain IP address and DNS from server. Login tab: retain defaults. Advanced tab: enable only <strong>accept plain text</strong>. No phone number or login script is required.')}</li><li>{tr(language,'Richt de IR-poorten recht op elkaar op ongeveer 10–30 cm. Open Web of Opera, bezoek eerst <code>http://start.retromodem/</code> en kies de nieuwe dienst wanneer EPOC daarom vraagt. De eerste IrDA-koppeling kan enkele seconden kosten.','Align the IR ports directly at a distance of roughly 10–30 cm. Open Web or Opera, first visit <code>http://start.retromodem/</code> and select the new service when EPOC asks. The first IrDA association can take several seconds.')}</li></ol>
<h3>{tr(language,'Inbelinternet via 5559000','Dial-up internet through 5559000')}</h3><p>{tr(language,'Kies op RetroModem <strong>Hayes-dial-up / BBS</strong>. Maak op de Psion een tweede internetdienst met hetzelfde modem, maar als inbelverbinding met telefoonnummer <code>5559000</code>, gebruiker <code>user</code> en leeg wachtwoord. Laat IP en DNS door de server toewijzen.','Select <strong>Hayes dial-up / BBS</strong> on RetroModem. Create a second Psion internet service using the same modem, but as a dial-up connection with phone number <code>5559000</code>, user <code>user</code> and a blank password. Let the server assign IP and DNS.')}</p>
<h3>{tr(language,'BBS’en met Comms of Hermes','Using BBSes with Comms or Hermes')}</h3><ol><li>{tr(language,'Kies op RetroModem Hayes-dial-up. Open Comms of Hermes, gebruik Infrared en dezelfde virtuele snelheid als op de Modem-pagina. Gebruik 8 databits, geen pariteit en 1 stopbit.','Select Hayes dial-up on RetroModem. Open Comms or Hermes, use Infrared and the same virtual speed shown on the Modem page. Use 8 data bits, no parity and 1 stop bit.')}</li><li>{tr(language,'Kies bij voorkeur ANSI/ANSI-BBS met IBM CP437; gebruik VT100 wanneer ANSI-BBS niet beschikbaar is. Zet Lokale echo uit (in Comms onder Extra → Vertaalcodes), anders verschijnen tekens dubbel.','Prefer ANSI/ANSI-BBS with IBM CP437; use VT100 when ANSI-BBS is unavailable. Disable Local echo (in Comms under Tools → Translation codes), otherwise characters appear twice.')}</li><li>{tr(language,'Richt de poorten uit en wacht tot de D-led continu brandt. Stuur <code>AT</code> plus Enter; het antwoord hoort <code>OK</code> te zijn. Bel daarna bijvoorbeeld <code>ATDT5551008</code> of een ander nummer uit het telefoonboek.','Align the ports and wait until the D LED is solid. Send <code>AT</code> plus Enter; the response should be <code>OK</code>. Then dial, for example, <code>ATDT5551008</code> or another number from the phone book.')}</li></ol>
<details class="guide-help"><summary>{tr(language,'Problemen oplossen','Troubleshooting')}</summary><ul><li>{tr(language,'Melding over ontbrekende locatie- of modemgegevens: bevestig Bellen opnieuw en controleer of de dienst modem RetroModem gebruikt.','Missing location or modem information: confirm Dialling again and verify that the service uses the RetroModem modem.')}</li><li>{tr(language,'Geen reactie op AT: Remote Link uit, lokale echo uit, IR-poorten opnieuw uitlijnen en enkele seconden wachten op de eerste IrCOMM-koppeling.','No response to AT: disable Remote Link and local echo, realign the IR ports and allow several seconds for the first IrCOMM association.')}</li><li>{tr(language,'Blijft “Looking up host name” staan: probeer de HTTP-testsite en controleer in de RetroModem-webinterface of wifi verbonden is.','If “Looking up host name” remains: try the HTTP test site and verify Wi-Fi connectivity in the RetroModem web interface.')}</li></ul></details>
<h3>{tr(language,'Bestanden','Files')}</h3><div class="notice warning"><strong>{tr(language,'Nog niet betrouwbaar.','Not yet reliable.')}</strong> {tr(language,'De ingebouwde EPOC-infraroodoverdracht kan halverwege of bij 95% afbreken. Alleen zeer kleine bestanden rond 1 KB zijn in de huidige configuratie praktisch gebleken, ook daarvoor bestaat geen garantie. Een bestand van 8 KB werkte eenmaal maar mislukte bij een identieke herhaling; 12 KB en groter is niet betrouwbaar. YMODEM via infrarood is eveneens apparaatafhankelijk en nog niet reproduceerbaar betrouwbaar. Gebruik voor grotere of belangrijke bestanden voorlopig een CF-kaart; YMODEM via USB-serieel moet nog fysiek worden geverifieerd. Ook de directe softwareknoppen hieronder kunnen via EPOC mislukken.','Native EPOC infrared transfer may stop midway or at 95%. Only very small files around 1 KB have proved practical in the current configuration, and even those are not guaranteed. An 8 KB file succeeded once but failed on an identical repeat; 12 KB and larger is not reliable. YMODEM over infrared is also device-dependent and not yet reproducibly reliable. For larger or important files, use a CF card for now; YMODEM over USB serial still requires physical verification. The direct software buttons below may therefore also fail over EPOC.')}</div><p>{tr(language,'Open in Comms Verzenden/Ontvangen en kies hetzelfde ASCII-, XMODEM-, YMODEM- of ZMODEM-protocol als op de Bestandsoverdrachtpagina. YMODEM werkte met een tweede 5mx in beide richtingen, maar niet betrouwbaar met het huidige testapparaat.','In Comms open Send/Receive and select the same ASCII-, XMODEM-, YMODEM- or ZMODEM protocol as on the File transfer page. YMODEM worked in both directions with a second 5mx, but not reliably with the current test device.')}</p><h3>{tr(language,'Nuttige software','Useful software')}</h3><div class="software-list">{software_card(language,title='Opera voor EPOC Release 5',description=tr(language,'Volwaardiger webbrowser voor de 5mx; veel moderne HTTPS-sites blijven onbruikbaar.','A more capable browser for the 5mx; many modern HTTPS sites remain unusable.'),compatibility='Psion 5mx · EPOC Release 5',source='https://software.psion.community/programs/uid/0x10004217/')}{software_card(language,title='Hermes',description=tr(language,'Sneller freeware-terminalprogramma als alternatief voor de ingebouwde Comms-app.','Faster freeware terminal application as an alternative to the built-in Comms app.'),compatibility='Psion Series 5/5mx',source='https://retrostuff.org/2019/12/09/serial-terminal-on-psion-serie-5mx-pro/')}</div><p>{tr(language,'Voor browsen kun je Opera of Web gebruiken; test eerst met <code>http://retroweb.bjrno.com</code>.','For browsing use Opera or Web; test first with <code>http://retroweb.bjrno.com</code>.')}</p></section>

<section class="card guide-panel" id="palm-old" hidden><h2>Palm OS 3.0/3.1</h2><p><strong>IrDA:</strong> {tr(language,'alleen modellen met ingebouwde IR-poort; deze generatie is nog niet fysiek getest.','only models with a built-in IR port; this generation has not yet been physically tested.')} <strong>{tr(language,'Serieel','Serial')}:</strong> {tr(language,'via cradle/kabel.','through a cradle/cable.')}</p><h3>Direct PPP</h3><ol><li>{tr(language,'Kies in Prefs → Serial/IR Infrared of Serial.','In Prefs → Serial/IR select Infrared or Serial.')}</li><li>{tr(language,'Prefs → Modem: 9600 voor IR; voor serieel dezelfde snelheid als RetroModem. Kies automatisch flow control.','Prefs → Modem: 9600 for IR; for serial use the same speed as RetroModem. Select automatic flow control.')}</li><li>{tr(language,'Prefs → Network: gebruiker <code>user</code>, leeg wachtwoord; Details: PPP. Werkt automatisch IP/DNS niet, gebruik dan IP <code>192.168.77.2</code> en DNS <code>1.1.1.1</code>/<code>8.8.8.8</code>. Script bevat alleen End.','Prefs → Network: user <code>user</code>, blank password; Details: PPP. If automatic IP/DNS fails, use IP <code>192.168.77.2</code> and DNS <code>1.1.1.1</code>/<code>8.8.8.8</code>. Script contains End only.')}</li></ol><h3>{tr(language,'Hayes-dial-up/BBS','Hayes dial-up/BBS')}</h3><p>{tr(language,'Alleen wanneer de Palm-verbinding modemcommando’s ondersteunt: bel 5559000 voor internet of een BBS-nummer. Gebruik een terminalprogramma voor interactieve BBS-sessies en zet local echo uit.','Only when the Palm connection supports modem commands: dial 5559000 for internet or a BBS number. Use a terminal application for interactive BBS sessions and disable local echo.')}</p><h3>{tr(language,'Bestanden','Files')}</h3><p>{tr(language,'Palm Beam gebruikt IrOBEX en is op de bestandspagina beschikbaar voor PRC/PDB-bestanden; deze oude OS-versies moeten nog worden getest. HotSync is iets anders en wordt niet nagebootst.','Palm Beam uses IrOBEX and is available on the file page for PRC/PDB files; these older OS releases still need testing. HotSync is separate and is not emulated.')}</p><h3>{tr(language,'Software','Software')}</h3><div class="software-list">{software_card(language,title='EudoraWeb 2.1',description=tr(language,'Snelle tekstbrowser zonder afbeeldingsondersteuning; PalmDB meldt compatibiliteit vanaf Palm OS 3.0.','Fast text browser without image support; PalmDB reports compatibility from Palm OS 3.0.'),compatibility='Palm OS 3.0–5.4 · freeware',software_id='eudoraweb-2.1',source='https://palmdb.net/app/eudora-eis')}{software_card(language,title='Mocha Telnet 3.0',description=tr(language,'Freeware Telnet/VT220- en SSH2-client voor klassieke Palms.','Freeware Telnet/VT220 and SSH2 client for classic Palms.'),compatibility='Palm OS 3.0+ · freeware · sleutel 119377',software_id='mocha-telnet-3.0',source='https://www.mochasoft.dk/palm2.htm')}</div></section>

<section class="card guide-panel" id="palm-new" hidden><h2>Palm OS 3.3–5.x</h2><p><strong>IrDA:</strong> {tr(language,'via Connection → Infrared waar aanwezig; getest op Palm IIIc met Palm OS 4.1.','through Connection → Infrared when available; tested on a Palm IIIc with Palm OS 4.1.')} <strong>{tr(language,'Serieel','Serial')}:</strong> {tr(language,'via cradle/kabel.','through a cradle/cable.')}</p><h3>Direct PPP</h3><ol><li>{tr(language,'Prefs → Connection → New: Connect to PC; Via Infrared of Serial.','Prefs → Connection → New: Connect to PC; Via Infrared or Serial.')}</li><li>{tr(language,'Details: 9600 voor IR; serieel gelijk aan RetroModem; Flow Ctl Automatic.','Details: 9600 for IR; serial equal to RetroModem; Flow Ctl Automatic.')}</li><li>{tr(language,'Prefs → Network: gebruiker <code>user</code>, leeg wachtwoord en de nieuwe verbinding. Details: PPP en Never. Zet Query DNS en Automatic IP uit; gebruik IP <code>192.168.77.2</code>, primaire DNS <code>1.1.1.1</code> en secundaire DNS <code>8.8.8.8</code>. Script: alleen End.','Prefs → Network: user <code>user</code>, blank password and the new connection. Details: PPP and Never. Disable Query DNS and Automatic IP; use IP <code>192.168.77.2</code>, primary DNS <code>1.1.1.1</code> and secondary DNS <code>8.8.8.8</code>. Script: End only.')}</li><li>{tr(language,'Richt de poorten uit en tik Connect. Signing on mag enkele seconden duren; RetroModem gebruikt bewust de normale PPP-onderhandelingstijd zodat Palm OS kan antwoorden.','Align the ports and tap Connect. Signing on may take several seconds; RetroModem deliberately uses the normal PPP negotiation interval so Palm OS has time to reply.')}</li></ol><h3>{tr(language,'Hayes-dial-up/BBS','Hayes dial-up/BBS')}</h3><p>{tr(language,'Maak indien beschikbaar een modemverbinding in plaats van PC Direct. Bel 5559000 voor internet of gebruik een terminalprogramma voor BBS-nummers; zet local echo daar uit.','When available, create a modem connection instead of PC Direct. Dial 5559000 for internet or use a terminal program for BBS numbers; disable local echo there.')}</p><h3>{tr(language,'Bestanden via Beam','Files through Beam')}</h3><p>{tr(language,'Open op de Palm de ontvangstfunctie voor Beam, kies op de Bestandsoverdrachtpagina <strong>Palm Beam</strong> en start daarna het verzenden. Dit gebruikt IrOBEX en staat los van HotSync. PRC- en PDB-bestanden worden ondersteund; RetroModem leest automatisch het Palm creator-ID.','Open Beam Receive on the Palm, select <strong>Palm Beam</strong> on the File transfer page and then start sending. This uses IrOBEX and is independent of HotSync. PRC and PDB files are supported; RetroModem reads the Palm creator ID automatically.')}</p><h3>{tr(language,'Nuttige software','Useful software')}</h3><div class="software-list">{software_card(language,title='EudoraWeb 2.1',description=tr(language,'Snelle tekstbrowser zonder afbeeldingen; deze freewareversie is met Palm OS 4.1 via Beam geïnstalleerd.','Fast text browser without images; this freeware release was installed over Beam on Palm OS 4.1.'),compatibility='Palm OS 3.0–5.4 · freeware',software_id='eudoraweb-2.1',source='https://palmdb.net/app/eudora-eis')}{software_card(language,title='Mocha Telnet 3.0',description=tr(language,'VT100/VT220- en SSH2-client, rechtstreeks van de freewarepagina van de maker.','VT100/VT220 and SSH2 client, obtained directly from the publisher’s freeware page.'),compatibility='Palm OS 3.0+ · freeware · sleutel 119377',software_id='mocha-telnet-3.0',source='https://www.mochasoft.dk/palm2.htm')}{software_card(language,title='ptelnet 0.7',description=tr(language,'GPLv3 Telnet/VT100-client; het project publiceert momenteel broncode maar geen gecontroleerde PRC-download.','GPLv3 Telnet/VT100 client; the project currently publishes source code but no verified PRC download.'),compatibility='Palm OS 3.5+ · GPLv3',source='https://github.com/migueletto/ptelnet')}{software_card(language,title='upIRC 3.8.3',description=tr(language,'IRC-client voor internetverbonden Palms; vanwege de onduidelijke distributiestatus alleen als externe verwijzing.','IRC client for networked Palms; external reference only because its distribution status is unclear.'),compatibility='Palm OS 3.0–5.4 · externe download',source='https://palmdb.net/app/upirc')}</div></section>

<section class="card guide-panel" id="hp200lx" hidden><h2>HP 200LX</h2><p><strong>IrDA:</strong> {tr(language,'niet compatibel met de huidige IrCOMM-driver; de 200LX gebruikt raw HPSIR.','not compatible with the current IrCOMM driver; the 200LX uses raw HPSIR.')} <strong>{tr(language,'Serieel','Serial')}:</strong> {tr(language,'de bruikbare route, met HP-seriële kabel en passende null-modemadapter.','the usable route, with an HP serial cable and suitable null-modem adapter.')}</p><h3>PPP</h3><p>{tr(language,'Gebruik DOS-PPP-software op COM1 en kies op RetroModem USB-serieel. Direct PPP is de eenvoudigste route; voor inbel-PPP kies je Hayes-dial-up en nummer 5559000. Snelheid en flow control moeten aan beide kanten gelijk zijn.','Use DOS PPP software on COM1 and select USB serial on RetroModem. Direct PPP is the simplest route; for dial-up PPP select Hayes dial-up and number 5559000. Speed and flow control must match at both ends.')}</p><h3>BBS</h3><p>{tr(language,'Gebruik een DOS-terminalprogramma op COM1, stuur <code>AT</code> en bel een nummer uit het telefoonboek. Zet local echo uit wanneer tekens dubbel verschijnen.','Use a DOS terminal program on COM1, send <code>AT</code> and dial a number from the phone book. Disable local echo if characters appear twice.')}</p><h3>{tr(language,'Bestanden','Files')}</h3><p>{tr(language,'Gebruik via de seriële kabel een terminalprogramma met X/Y/ZMODEM en kies op RetroModem hetzelfde protocol. LapLink en raw HPSIR worden door de huidige backend niet aangeboden.','Over the serial cable use a terminal application offering X/Y/ZMODEM and select the same protocol on RetroModem. LapLink and raw HPSIR are not provided by the current backend.')}</p></section>

<section class="card guide-panel" id="win95" hidden><h2>Windows 95</h2><p><strong>{tr(language,'Serieel','Serial')}:</strong> {tr(language,'aanbevolen en het meest voorspelbaar.','recommended and most predictable.')} <strong>IrDA:</strong> {tr(language,'alleen met een ondersteunde infraroodpoort en passende Windows-driver; dit staat los van de MY018- of MA-620-keuze op de Pi. Ondersteuning verschilt per Windows 95-uitgave; deze route is niet fysiek getest.','only with a supported infrared port and matching Windows driver; this is separate from choosing MY018 or MA-620 on the Pi. Support varies by Windows 95 release; this route is not physically tested.')}</p><h3>{tr(language,'Internet','Internet')}</h3><p>{tr(language,'Installeer een standaardmodem op de gekozen COM-poort. Kies Hayes-dial-up op RetroModem en maak in Dial-Up Networking een verbinding naar <code>5559000</code>, gebruiker <code>user</code>, leeg wachtwoord. Voor Direct PPP is een directe-kabelverbinding/DCC-configuratie nodig.','Install a standard modem on the selected COM port. Select Hayes dial-up on RetroModem and create a Dial-Up Networking connection to <code>5559000</code>, user <code>user</code>, blank password. Direct PPP requires a direct-cable/DCC configuration.')}</p><h3>BBS</h3><p>{tr(language,'Gebruik HyperTerminal, dezelfde COM-snelheid en 8-N-1. Stuur <code>AT</code>, daarna bijvoorbeeld <code>ATDT5551000</code>; Local echo uit.','Use HyperTerminal, matching COM speed and 8-N-1. Send <code>AT</code>, then for example <code>ATDT5551000</code>; disable Local echo.')}</p><h3>{tr(language,'Bestanden','Files')}</h3><p>{tr(language,'HyperTerminal ondersteunt XMODEM, YMODEM en ZMODEM. Start aan één kant eerst ontvangen en kies op de RetroModem-pagina exact hetzelfde protocol.','HyperTerminal supports XMODEM, YMODEM and ZMODEM. Start receive on one side first and select exactly the same protocol on the RetroModem page.')}</p></section>

<section class="card guide-panel" id="win98" hidden><h2>Windows 98</h2><p><strong>IrDA:</strong> {tr(language,'vereist een door Windows ondersteunde infraroodpoort en driver op de pc; de adapter op de Pi kies je apart. Deze route is niet fysiek getest.','requires a Windows-supported infrared port and driver on the PC; select the Pi adapter separately. This route is not physically tested.')} <strong>{tr(language,'Serieel','Serial')}:</strong> {tr(language,'via COM-poort en standaardmodem.','through a COM port and standard modem.')}</p><h3>{tr(language,'Internet','Internet')}</h3><p>{tr(language,'Voor serieel: standaardmodem plus Dial-Up Networking naar 5559000. Voor IR: kies de infrarood- of virtuele COM-poort die Windows aanmaakt. Gebruiker <code>user</code>, leeg wachtwoord, server assigned IP en DNS. Direct PPP kan via Direct Cable Connection.','For serial: standard modem plus Dial-Up Networking to 5559000. For IR: select the infrared or virtual COM port created by Windows. User <code>user</code>, blank password, server-assigned IP and DNS. Direct PPP can use Direct Cable Connection.')}</p><h3>BBS</h3><p>{tr(language,'Gebruik HyperTerminal op de seriële of infrarode virtuele COM-poort, 8-N-1, local echo uit, en bel met ATDT.','Use HyperTerminal on the serial or infrared virtual COM port, 8-N-1, local echo off, and dial using ATDT.')}</p><h3>{tr(language,'Bestanden','Files')}</h3><p>{tr(language,'Voor Wireless Link: lijn de IR-poorten uit, zet de ontvangende kant klaar en kies op de bestandspagina <strong>Windows Wireless Link (IrOBEX)</strong>. Voor HyperTerminal blijven X/Y/ZMODEM beschikbaar. Deze Wireless Link-route is geïmplementeerd maar nog niet fysiek getest.','For Wireless Link: align the IR ports, prepare the receiving side and select <strong>Windows Wireless Link (IrOBEX)</strong> on the file page. X/Y/ZMODEM remain available for HyperTerminal. This Wireless Link route is implemented but not yet physically tested.')}</p></section>
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
