BjornB2/retromodem/web/proxy_web.py

"""Small cookie-free proxy content settings for retro browsers."""
import re
import secrets
import threading
import time
import urllib.parse

try:
    import wifi_web as ui
except ModuleNotFoundError:
    from web import wifi_web as ui

PAGE_SIZES = ('12000', '18000', *(str(n * 1000) for n in range(25, 201, 25)),
              *(str(n * 1000) for n in range(250, 2001, 250)), '0')
PRESETS = {'600x180': 'Psion 5mx', '144x120': 'Palm classic',
           '288x256': 'Palm HiRes', '288x400': 'Palm T3', '512x342': 'Macintosh Plus'}
PROFILES = {'auto': 'Automatic', 'generic': 'Generic legacy browser', 'macweb': 'MacWeb', 'psion': 'Psion/EPOC Web',
            'psion5mx': 'Psion Series 5mx', 'palm': 'Palm browser', 'nokia9210': 'Nokia 9210/9210i',
            'ie_win98': 'Internet Explorer on Windows 98', 'text': 'Text only'}
FIELDS = {'session', 'csrf', 'mode', 'profile', 'page_size', 'page_images', 'tables', 'layout',
          'image_start', 'image_preset', 'image_width', 'image_height'}
_sessions = {}
_lock = threading.RLock()


def _new(peer):
    now = time.monotonic()
    with _lock:
        for key in list(_sessions):
            if _sessions[key]['expires'] <= now:
                del _sessions[key]
        while len(_sessions) >= 64:
            del _sessions[next(iter(_sessions))]
        token = secrets.token_hex(32)
        _sessions[token] = {'peer': peer, 'csrf': secrets.token_hex(32), 'expires': now + 900}
        return token, _sessions[token]['csrf']


def content_settings(page_size, image_start, width, height, profile='auto', page_images='all', tables='auto', layout='auto', image_size_mode='custom'):
    """Validation shared with the full administration UI."""
    if page_size not in PAGE_SIZES or image_start not in {'profile', 'inline', 'links', 'remember'}:
        raise ValueError('Invalid proxy content settings')
    if any(not re.fullmatch(r'[0-9]{1,4}', value) or not 16 <= int(value) <= 4096
           for value in (width, height)):
        raise ValueError('Invalid image dimensions')
    if profile not in PROFILES or page_images not in {'all', *(str(n) for n in range(11))}:
        raise ValueError('Invalid profile or image limit')
    if tables not in {'auto', 'table', 'linearise'} or layout not in {'auto', 'flow', 'table'}:
        raise ValueError('Invalid table or layout mode')
    if image_size_mode not in {'profile', 'custom'}:
        raise ValueError('Invalid image size mode')
    return {'RETROMODEM_PROXY_PAGE_SIZE': page_size, 'RETROMODEM_PROXY_IMAGE_START': image_start,
            'RETROMODEM_PROXY_IMAGE_WIDTH': str(int(width)), 'RETROMODEM_PROXY_IMAGE_HEIGHT': str(int(height)),
            'RETROMODEM_PROXY_PROFILE': profile, 'RETROMODEM_PROXY_PAGE_IMAGES': page_images,
            'RETROMODEM_PROXY_TABLES': tables, 'RETROMODEM_PROXY_LAYOUT': layout,
            'RETROMODEM_PROXY_IMAGE_SIZE_MODE': image_size_mode}


def _changes(form):
    if set(form) != FIELDS:
        raise ValueError('Invalid fields')
    if form['mode'] not in {'transparent', 'transparent-online', 'manual'}:
        raise ValueError('Invalid proxy mode')
    preset = form['image_preset']
    if preset in {'custom', 'profile'}:
        width, height = form['image_width'], form['image_height']
    elif preset in PRESETS:
        width, height = preset.split('x')
    else:
        raise ValueError('Invalid preset')
    return {**content_settings(form['page_size'], form['image_start'], width, height, form['profile'],
                               form['page_images'], form['tables'], form['layout'],
                               'profile' if preset == 'profile' else 'custom'),
            'RETROMODEM_PROXY_MODE': form['mode']}


def serve(handler, *, save, apply_mode):
    config = handler.config()
    t = lambda nl, en: ui.local_ui.tr(config.get('RETROMODEM_LANGUAGE', 'en'), nl, en)
    title = t('Webproxy instellen', 'Web proxy settings')
    peer = ui._peer(handler, config)
    reply = lambda body, code=200: ui._reply(handler, title, body, code)
    back = '<p><a href="/">' + t('Opnieuw openen', 'Start again') + '</a></p>'
    if peer is None:
        reply('<p>' + t('Alleen via de retroverbinding of met beheerderslogin.',
                       'Available only over the retro connection or with administrator authentication.') + '</p>', 403)
        return
    path = urllib.parse.urlsplit(handler.path).path
    message = ''
    if handler.command == 'POST' and path == '/save':
        origin = handler.headers.get('Origin')
        if origin:
            try:
                parsed = urllib.parse.urlsplit(origin)
                valid = (parsed.scheme == 'http' and parsed.hostname == 'proxy.retromodem'
                         and parsed.port in (None, 80, 8080) and not parsed.username and not parsed.password
                         and parsed.path in ('', '/') and not parsed.query and not parsed.fragment)
            except ValueError:
                valid = False
            if not valid:
                reply('<p>' + t('Ongeldige herkomst van het formulier.', 'Invalid form origin.') + '</p>', 403)
                return
        try:
            if handler.headers.get('Transfer-Encoding'):
                raise ValueError('Transfer encoding')
            form = ui._body_form(handler)
        except (ValueError, UnicodeError):
            reply('<p>' + t('Ongeldig formulier.', 'Invalid form.') + '</p>' + back, 400)
            return
        with _lock:
            item = _sessions.get(form.get('session', ''))
            valid = (item and item['peer'] == peer and item['expires'] > time.monotonic()
                     and secrets.compare_digest(form.get('csrf', '').encode('utf-8'), item['csrf'].encode('ascii')))
            if not valid:
                reply('<p>' + t('Formulier verlopen; open de pagina opnieuw.', 'Form expired; reopen the page.') + '</p>' + back, 403)
                return
            try:
                changes = _changes(form)
            except ValueError:
                reply('<p>' + t('Ongeldige instellingen. Breedte en hoogte moeten 16–4096 pixels zijn.',
                               'Invalid settings. Width and height must be 16–4096 pixels.') + '</p>' + back, 400)
                return
            del _sessions[form['session']]  # A repeated POST cannot save again.
        old_mode = config.get('RETROMODEM_PROXY_MODE', 'transparent')
        if old_mode not in {'transparent', 'transparent-online', 'manual'}:
            old_mode = 'transparent'
        try:
            save(changes)
        except OSError:
            reply('<p>' + t('Opslaan is niet gelukt. Open de pagina opnieuw en probeer nogmaals.',
                           'Saving failed. Reopen the page and try again.') + '</p>' + back, 500)
            return
        if changes['RETROMODEM_PROXY_MODE'] != old_mode and not apply_mode():
            save({'RETROMODEM_PROXY_MODE': old_mode})
            apply_mode()
            reply('<p>' + t('De proxystand kon niet worden toegepast; de vorige stand is hersteld.',
                           'The proxy mode could not be applied; the previous mode was restored.') + '</p>' + back, 500)
            return
        config = handler.config()
        message = '<p><strong>' + t('Opgeslagen.', 'Saved.') + '</strong> ' + t(
            'Open de oorspronkelijke website opnieuw voor nieuwe paginadelen en afbeeldingsformaten.',
            'Reopen the original website for new page parts and image dimensions.') + '</p>'
    elif handler.command != 'GET' or path != '/':
        reply('<p>' + t('Pagina niet gevonden.', 'Page not found.') + '</p>', 404)
        return
    page = config.get('RETROMODEM_PROXY_PAGE_SIZE', '250000')
    if page not in PAGE_SIZES:
        page = '250000'
    start = config.get('RETROMODEM_PROXY_IMAGE_START', config.get('RETROMODEM_PROXY_IMAGE_MODE', 'inline'))
    if start not in {'profile', 'inline', 'links', 'remember'}:
        start = 'inline'
    dimensions = []
    for key, fallback in (('WIDTH', '200'), ('HEIGHT', '150')):
        value = config.get('RETROMODEM_PROXY_IMAGE_' + key, config.get('RETROMODEM_68KPROXY_IMAGE_' + key, fallback))
        dimensions.append(value if re.fullmatch(r'[0-9]{1,4}', value) and 16 <= int(value) <= 4096 else fallback)
    width, height = dimensions
    profile = config.get('RETROMODEM_PROXY_PROFILE', 'auto'); profile = profile if profile in PROFILES else 'auto'
    page_images = config.get('RETROMODEM_PROXY_PAGE_IMAGES', 'all'); page_images = page_images if page_images in {'all', *(str(n) for n in range(11))} else 'all'
    tables = config.get('RETROMODEM_PROXY_TABLES', 'auto'); tables = tables if tables in {'auto', 'table', 'linearise'} else 'auto'
    layout = config.get('RETROMODEM_PROXY_LAYOUT', 'auto'); layout = layout if layout in {'auto', 'flow', 'table'} else 'auto'
    image_size_mode = config.get('RETROMODEM_PROXY_IMAGE_SIZE_MODE', 'custom')
    image_size_mode = image_size_mode if image_size_mode in {'profile', 'custom'} else 'custom'
    mode = config.get('RETROMODEM_PROXY_MODE', 'transparent')
    if mode not in {'transparent', 'transparent-online', 'manual'}:
        mode = 'transparent'
    def options(choices, selected):
        return ''.join('<option value="' + ui._escape(value, True) + '"' + (' selected' if value == selected else '') + '>' + ui._escape(label) + '</option>' for value, label in choices)
    page_options = [(value, t('Volledige pagina (kans op vol geheugen)', 'Entire page (may exhaust memory)') if value == '0' else str(int(value) // 1000) + ' kB') for value in PAGE_SIZES]
    contents = ('<p>' + t('Webverkeer:', 'Web traffic:') + '<br><select name="mode">' +
                options((('transparent', t('Stuur al het webverkeer automatisch over de proxy',
                                           'Automatically send all web traffic through the local proxy')),
                         ('transparent-online', t('Automatisch via retroweb.bjrno.com', 'Automatically through retroweb.bjrno.com')),
                         ('manual', t('Gebruik de proxy alleen wanneer deze in de browser is ingesteld',
                                      'Use the proxy only when configured in the browser'))), mode) +
                '</select></p><p>' + t('In de automatische stand hoeft de browser geen proxy-instelling te hebben. In de handmatige stand gebruik je HTTP-proxy 192.168.77.1, poort 8080.',
                                      'Automatic mode needs no browser proxy setting. In manual mode use HTTP proxy 192.168.77.1, port 8080.') + '</p><p>' +
                (''.join('<input type="hidden" name="' + n + '" value="' + ui._escape(v, True) + '">' for n,v in (('profile',profile),('page_size',page),('page_images',page_images),('tables',tables),('layout',layout),('image_start',start),('image_preset',image_size_mode),('image_width',width),('image_height',height))) + '<p><b>' + t('De onderstaande lokale RetroWEB-instellingen zijn uitgeschakeld in de online stand.', 'The local RetroWEB settings below are disabled in online mode.') + '</b></p>' if mode == 'transparent-online' else '') +
                '<fieldset' + (' disabled' if mode == 'transparent-online' else '') + '><p>' + t('Browserprofiel:', 'Browser profile:') + '<br><select name="profile">' + options([(v, t('Automatisch','Automatic') if v == 'auto' else l) for v,l in PROFILES.items()], profile) + '</select></p><p>' +
                t('Geschatte paginagrootte per deel:', 'Estimated page size per part:') +
                '<br><select name="page_size">' + options(page_options, page) + '</select></p><p>' +
                t('Dit is HTML plus uitgepakte afbeeldingen na conversie, geen downloadgrootte of gegarandeerde geheugenlimiet. Bij afbeeldingen als links telt alleen HTML. 250 kB is de standaard voor nieuwe installaties.',
                  'This is HTML plus decoded images after conversion, not download size or a guaranteed memory limit. With images as links only HTML counts. 250 kB is the default for new installations.') + '</p><p>' +
                t('Afbeeldingen bij nieuwe verbinding:', 'Images at new connection:') + '<br><select name="image_start">' +
                options((('profile', t('Volgens browserprofiel', 'According to browser profile')), ('inline', t('Afbeeldingen laten zien', 'Show images')), ('links', t('Als links', 'As links')), ('remember', t('Vorige keuze onthouden', 'Remember previous choice'))), start) + '</select></p><p>' +
                t('Deze startstand geldt vanaf de volgende PPP-verbinding. Op een geopende proxypagina kun je de huidige weergave bovenaan wisselen.',
                  'This starting mode applies from the next PPP connection. Change the current view at the top of an open proxy page.') + '</p><p>' +
                t('Afbeeldingsformaat:', 'Image size:') + '<br><select name="image_preset">' +
                options([('profile', t('Volgens browserprofiel', 'According to browser profile')), ('custom', t('Huidig / aangepast', 'Current / custom'))] + [(value, label + ' (' + value + ')') for value, label in PRESETS.items()], image_size_mode) + '</select></p><p>' +
                t('Een apparaatpreset vult bij opslaan de afmetingen in. Alleen bij Huidig / aangepast gelden onderstaande waarden (16–4096 pixels).',
                  'A device preset sets dimensions when saved. The values below apply only with Current / custom (16–4096 pixels).') + '</p><p>' +
                t('Maximale breedte:', 'Maximum width:') + '<br><input name="image_width" size="5" maxlength="4" value="' + width + '"><br>' +
                t('Maximale hoogte:', 'Maximum height:') + '<br><input name="image_height" size="5" maxlength="4" value="' + height + '"></p><p>' +
                t('Maximum afbeeldingen:', 'Maximum images:') + '<br><select name="page_images">' + options([('all',t('Alle','All'))]+[(str(n),str(n)) for n in range(11)], page_images) + '</select></p><p>' +
                t('Tabellen:', 'Tables:') + '<br><select name="tables">' + options((('auto',t('Automatisch','Automatic')),('table',t('Klassieke tabel','Classic table')),('linearise',t('Lineaire tekst','Linear text'))), tables) + '</select></p><p>' +
                t('Pagina-indeling:', 'Page layout:') + '<br><select name="layout">' + options((('auto',t('Automatisch','Automatic')),('flow',t('Eén kolom','Single column')),('table',t('Grid/Flex als tabellen','Grid/Flex as tables'))), layout) + '</select></p></fieldset>')
    token, csrf = _new(peer)
    reply(message + '<p>' + t('Deze instellingen gelden ook in de beheerinterface. De verbinding blijft actief.',
                              'These settings are shared with administration. The connection stays active.') + '</p>' +
          ui._form('/save', token, contents, t('Opslaan', 'Save'), csrf) +
          '<p><a href="http://setup.retromodem/">' + t('Instellingen', 'Settings') +
          '</a> | <a href="http://start.retromodem/">' + t('Startpagina', 'Home') + '</a></p>')
