BjornB2/retromodem/src/my018/irtty-sir.h

/*********************************************************************
 *
 *	sir_tty.h:	definitions for the irtty_sir client driver (former irtty)
 *
 *	Copyright (c) 2002 Martin Diehl
 *
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
 ********************************************************************/

#ifndef IRTTYSIR_H
#define IRTTYSIR_H

#include <net/irda/irda.h>
#include <net/irda/irda_device.h>		// chipio_t

#define IRTTY_IOC_MAGIC 'e'
#define IRTTY_IOCTDONGLE  _IO(IRTTY_IOC_MAGIC, 1)
#define IRTTY_IOCGET     _IOR(IRTTY_IOC_MAGIC, 2, struct irtty_info)
#define IRTTY_IOC_MAXNR   2

struct sirtty_cb {
	magic_t magic;

	struct sir_dev *dev;
	struct tty_struct  *tty;
	struct work_struct tx_work;

	chipio_t io;               /* IrDA controller information */
};

#endif
