BjornB2/retromodem/tests/palm_progress_roundtrip.c

/* Validate the upstream streaming sender over a local socket, without IR.
 * SPDX-License-Identifier: GPL-3.0-or-later
 */
#include <openobex/obex.h>
#include "obex_io.h"
#include "obex_put_common.h"
#include <sys/socket.h>
#include <unistd.h>
#include <stdio.h>
#include <stdlib.h>
#include <fcntl.h>

obex_t *handle;
volatile int finished;
static size_t expected_size;
static int received_ok;
extern volatile int last_rsp;

static void receiver(obex_t *self, obex_object_t *object, int mode,
                     int event, int command, int response)
{
    (void)mode; (void)command; (void)response;
    if (event == OBEX_EV_REQHINT)
        OBEX_ObjectSetRsp(object, OBEX_RSP_CONTINUE, OBEX_RSP_SUCCESS);
    if (event == OBEX_EV_REQ) {
        obex_headerdata_t data;
        uint8_t id;
        uint32_t length;
        while (OBEX_ObjectGetNextHeader(self, object, &id, &data, &length)) {
            if (id == OBEX_HDR_BODY || id == OBEX_HDR_BODY_END) {
                received_ok = length == expected_size;
                for (size_t n = 0; n < length; n++)
                    if (data.bs[n] != (uint8_t)(n % 251)) received_ok = 0;
            }
        }
        OBEX_ObjectSetRsp(object, OBEX_RSP_CONTINUE,
                         received_ok ? OBEX_RSP_SUCCESS : OBEX_RSP_BAD_REQUEST);
    }
}
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
