BjornB2/retromodem/(commit log)

2026-10-28 Prepare tested feature fixes, guarded updates and prototype enclosure
2026-10-28 Fix tcpser flow control corrupting extended Linux baudrates
2026-10-28 Record accepted live dial-up test after modem and timer fixes
2026-10-29 Refresh bilingual general, proxy and device guides around current workflow
2026-10-29 Document prototype wiring and power boards
2026-10-29 Show the infrared prototype in README photos
2026-10-29 Add printable RetroModem quick reference
2026-11-07 Refetch source when switching image mode
2026-11-07 Replace local RetroWEB core with public proxy relay
