BjornB2/retromodem/(notices)

Notices in the files:
src/my018/irtty-sir.c:
modify it under the terms of the GNU General Public License as
published by the Free Software Foundation; either version 2 of
the License, or (at your option) any later version.
